huskyroboticsteam/Chassis-Power-Distro-PCB-A-2019-2020/Rev 1.1/PowerDistro BOM_2019-2020.xlsx

Item # | Description | Quantity | Value | Part Number | Link to Part | Manufacturer Part # | PackageReference | Price per Unit | Total Price
1 | CAPACITORS:
2 | CAP CER 3.3UF 35V X7R 0805 | 1 | 3.3u | 445-7553-1-ND | https://www.digikey.com/product-detail/en/tdk-corporation/C2012X7R1V335K125AC/445-7553-1-ND/2733625 | C2012X7R1V335K125AC | 0805 | $0.59 | $0.59
3 | CAP CER 0.47UF 50V X7R 0805 | 3 | 470n | 399-8100-1-ND | https://www.digikey.com/product-detail/en/kemet/C0805C474K5RACTU/399-8100-1-ND/3471823 | C0805C474K5RACTU | 0805 | $0.35 | $1.05 | ???
4 | CAP CER 0.1UF 50V X7R 0805 | 8 | 0.1u | 399-1169-1-ND | https://www.digikey.com/product-detail/en/kemet/C0805C104M5RACTU/399-1169-1-ND/411444 | C0805C104M5RACTU | 0805 | $0.10 | $0.80
5 | CAP CER 2.2UF 50V X7R 0805 | 21 | 2.2u | 445-174216-1-ND | https://www.digikey.com/product-detail/en/tdk-corporation/CGA4J3X7R1H225K125AB/445-174216-1-ND/5823086 | CGA4J3X7R1H225K125AB | 0805 | $0.49 | $10.29
6 | CAP ALUM 680UF 20% 35V RADIAL | 3 | 680u | P12417-ND | https://www.digikey.com/product-detail/en/panasonic-electronic-components/EEU-FM1V681/P12417-ND/613778 | EEU-FM1V681 | Radial | $0.85 | $2.55
7 | CAP ALUM 330UF 20% 35V RADIAL | 3 | 330u | P10299-ND | https://www.digikey.com/product-detail/en/panasonic-electronic-components/EEU-FC1V331/P10299-ND/266308 | EEU-FC1V331 | Radial | $0.63 | $1.89
8 | CAP CER 820PF 50V X7R 0805 | 4 | 820p | 399-1145-1-ND | https://www.digikey.com/product-detail/en/kemet/C0805C821K5RACTU/399-1145-1-ND/411420 | C0805C821K5RACTU | 0805 | $0.32 | $1.28
9 | CAP CER 22UF 35V JB 0805 | 7 | 22u | 445-11527-1-ND | https://www.digikey.com/product-detail/en/tdk-corporation/C2012JB1V226M125AC/445-11527-1-ND/3953193 | C2012JB1V226M125AC | 0805 | $1.14 | $7.98
10 | CAP CER 0.015UF 25V X7R 0805 | 3 | 15n | 732-8056-1-ND | https://www.digikey.com/product-detail/en/w-rth-elektronik/885012207067/732-8056-1-ND/5454683 | 885012207067 | 0805 | $0.10 | $0.30
11 | CAP CER 0.47UF 50V X7R 0805 | 3 | 0.47u | 399-8100-1-ND | https://www.digikey.com/product-detail/en/kemet/C0805C474K5RACTU/399-8100-1-ND/3471823 | C0805C474K5RACTU | 0805 | $0.35 | $1.05
12 | CAP CER 1000PF 50V X7R 0805 | 3 | 1000p | 399-1149-1-ND | https://www.digikey.com/product-detail/en/kemet/C0805C102J5RACTU/399-1149-1-ND/411424 | C0805C102J5RACTU | 0805 | $0.15 | $0.45
13 | CAP CER 82PF 50V C0G/NP0 0805 | 2 | 82p | 399-1120-1-ND | https://www.digikey.com/product-detail/en/kemet/C0805C820J5GACTU/399-1120-2-ND/411119 | C0805C820J5GACTU | 0805 | $0.17 | $0.34
14 | CAP CER 9100PF 50V C0G/NP0 0805 | 1 | 9n | 399-15072-1-ND | https://www.digikey.com/product-detail/en/kemet/C0805C912J5GAC7800/399-15072-1-ND/7382621 | C0805C912J5GAC7800 | 0805 | $0.87 | $0.87
15 | CAP CER 3900PF 50V X7R 0805 | 1 | 4n | 399-1154-1-ND | https://www.digikey.com/product-detail/en/kemet/C0805C392K5RACTU/399-1154-1-ND/411429 | C0805C392K5RACTU | 0805 | $0.11 | $0.11
16 | CAP CER 12PF 25V C0G/NP0 0805 | 1 | 12p | 399-17427-1-ND | https://www.digikey.com/product-detail/en/kemet/C0805C120J3GAC7800/399-17427-1-ND/8570394 | C0805C120J3GAC7800 | 0805 | $0.25 | $0.25
17
18 | RESISTORS:
19
20 | RES SMD 4.32K OHM 0.5% 1/4W 0805 | 3 | 4.32k | P21091CT-ND | https://www.digikey.com/product-detail/en/panasonic-electronic-components/ERJ-PB6D4321V/P21091CT-ND/6215346 | ERJ-PB6D4321V | 0805 | $0.25 | $0.75 |  | Missing: | 14k ohm | R29
21 | RES 10 OHM 1/4W 5% AXIAL | 12 | 10ohms | CF14JT10R0CT-ND | https://www.digikey.com/product-detail/en/stackpole-electronics-inc/CF14JT10R0/CF14JT10R0CT-ND/1830306 | CF14JT10R0 | Axial | $0.10 | $1.20 |  |  | 60.8k ohm | R34
22 | RES SMD 45.3K OHM 0.5% 1/4W 0805 | 1 | 45.3k | P21207CT-ND | https://www.digikey.com/product-detail/en/panasonic-electronic-components/ERJ-PB6D4532V/P21207CT-ND/6215462 | ERJ-PB6D4532V | 0805 | $0.25 | $0.25
23 | RES 2K OHM 1% 1/4W 0805 | 1 | 2k | RNCP0805FTD2K00CT-ND | https://www.digikey.com/product-detail/en/stackpole-electronics-inc/RNCP0805FTD2K00/RNCP0805FTD2K00CT-ND/2240576 | RNCP0805FTD2K00 | 0805 | $0.10 | $0.10
24 | RES SMD 316 OHM 0.1% 1/4W 0805 | 1 | 316ohms | P20535CT-ND | https://www.digikey.com/product-detail/en/panasonic-electronic-components/ERJ-PB6B3160V/P20535CT-ND/6214790 | ERJ-PB6B3160V | 0805 | $0.36 | $0.36
25 | RES SMD 340 OHM 0.1% 1/4W 0805 | 1 | 340ohms | A110498CT-ND | https://www.digikey.com/product-detail/en/te-connectivity-passive-product/7-2176091-3/A110498CT-ND/4034853 | 7-2176091-3 | 0805 | $0.66 | $0.66
26 | RES SMD 5.1K OHM 0.5% 1/4W 0805 | 3 | 5.1k | P21099CT-ND | https://www.digikey.com/product-detail/en/panasonic-electronic-components/ERJ-PB6D5101V/P21099CT-ND/6215354 | ERJ-PB6D5101V | 0805 | $0.25 | $0.75
27 | RES SMD 12.1K OHM 0.5% 1/4W 0805 | 3 | 12.1k | P21142CT-ND | https://www.digikey.com/product-detail/en/panasonic-electronic-components/ERJ-PB6D1212V/P21142CT-ND/6215397 | ERJ-PB6D1212V | 0805 | $0.25 | $0.75
28 | RES 0.012 OHM 1% 1W 2512 | 3 | 12m | P12MCT-ND | https://www.digikey.com/product-detail/en/panasonic-electronic-components/ERJ-M1WSF12MU/P12MCT-ND/300474 | ERJ-M1WSF12MU | 2412 | $0.70 | $2.10
29 | RES 8.76K OHM 0.1% 1/5W 0805 | 1 | 8.76k | 541-4579-1-ND | https://www.digikey.com/product-detail/en/vishay-dale/TNPW08058K76BEEA/541-4579-1-ND/9448583 | TNPW08058K76BEEA | 0805 | $0.60 | $0.60
30 | RES SMD 88.7 OHM 0.1% 1/4W 0805 | 1 | 86.7ohms | A110442CT-ND | https://www.digikey.com/product-detail/en/te-connectivity-passive-product/1-2176091-9/A110442CT-ND/4034797 | 1-2176091-9 | 0805 | $0.66 | $0.66
31 | RES SMD 68.1K OHM 0.1% 1/4W 0805 | 1 | 68.1k | A110719CT-ND | https://www.digikey.com/product-detail/en/te-connectivity-passive-product/7-2176093-9/A110719CT-ND/4035074 | 7-2176093-9 | 0805 | $0.66 | $0.66
32 | RES SMD 6.04K OHM 0.1% 1/4W 0805 | 1 | 6.04k | P20683CT-ND | https://www.digikey.com/product-detail/en/panasonic-electronic-components/ERJ-PB6B6041V/P20683CT-ND/6214938 | ERJ-PB6B6041V | 0805 | $0.36 | $0.36 | ???
33 | RES SMD 1.15K OHM 0.1% 1/4W 0805 | 1 | 1.15k | P20600CT-ND | https://www.digikey.com/product-detail/en/panasonic-electronic-components/ERJ-PB6B1151V/P20600CT-ND/6214855 | ERJ-PB6B1151V | 0805 | $0.36 | $0.36 | ???
34 | RES SMD 44.2K OHM 0.1% 1/4W 0805 | 1 | 44.2k | P20781CT-ND | https://www.digikey.com/product-detail/en/panasonic-electronic-components/ERJ-PB6B4422V/P20781CT-ND/6215036 | ERJ-PB6B4422V | 0805 | $0.36 | $0.36
35 | RES SMD 154K OHM 0.1% 1/4W 0805 | 1 | 154k | P20841CT-ND | https://www.digikey.com/product-detail/en/panasonic-electronic-components/ERJ-PB6B1543V/P20841CT-ND/6215096 | ERJ-PB6B1543V | 0805 | $0.36 | $0.36
36 | RES SMD 60.4K OHM 0.1% 1/4W 0805 | 1 | 60.8k | P20797CT-ND | https://www.digikey.com/product-detail/en/panasonic-electronic-components/ERJ-PB6B6042V/P20797CT-ND/6215052 | ERJ-PB6B6042V | 0805 | $0.36 | $0.36
37 | RES SMD 665 OHM 0.1% 1/4W 0805 | 1 | 667ohms | P20574CT-ND | https://www.digikey.com/product-detail/en/panasonic-electronic-components/ERJ-PB6B6650V/P20574CT-ND/6214829 | ERJ-PB6B6650V | 0805 | $0.36 | $0.36
38 | RES SMD 1.47K OHM 0.1% 1/4W 0805 | 2 | 1.47k | P20611CT-ND | https://www.digikey.com/product-detail/en/panasonic-electronic-components/ERJ-PB6B1471V/P20611CT-ND/6214866 | ERJ-PB6B1471V | 0805 | $0.36 | $0.72
39 | RES SMD 0 OHM JUMPER 1/2W 0805 | 3 | 0 | 541-0.0TBCT-ND | https://www.digikey.com/product-detail/en/vishay-dale/CRCW08050000Z0EAHP/541-0.0TBCT-ND/2222831 | CRCW08050000Z0EAHP | 0805 | $0.23 | $0.69
40
41 | ICs/Other:
42 | FUSE BOARD MOUNT 2A 32VDC 0805 | 1 |  | 749-1743-1-ND | https://www.digikey.com/product-detail/en/vishay-beyschlag/MFU0805FF02000P500/749-1743-1-ND/7348051 | MFU0805FF02000P500 |  | $0.48 | $0.48
43 | CONN HDR 2POS 7.50MM PCB SLDR | 3 |  | WM16294-ND | https://www.digikey.com/products/en?keywords=1720420202 | 1720420202 |  | $1.84 | $5.52
44 | Fixed Inductors 15uH 20% 13.8A 18.6mOhms AEC-Q200 | 1 |  | 994-XAL1010-153MEB | https://www.mouser.com/ProductDetail/Coilcraft/XAL1010-153MEB | XAL1010-153MEB |  | $5.25 | $5.25
45 | Fixed Inductors 6.8uH 20% 18.5A 8.9mOhms AEC-Q200 | 2 |  | 994-XAL1010-682MEB | https://www.mouser.com/ProductDetail/Coilcraft/XAL1010-682MEB | XAL1010-682MEB |  | $5.25 | $10.50
46 | MOSFET N-CH 60V 115MA SOT-23 | 3 |  | 2N7002NCT-ND | https://www.digikey.com/product-detail/en/on-semiconductor/2N7002/2N7002NCT-ND/244664 | 2N7002 |  | $0.33 | $0.99
47 | SWITCH TACTILE SPST-NO 0.05A 24V | 1 |  | 450-1804-ND | https://www.digikey.com/product-detail/en/te-connectivity-alcoswitch-switches/1825910-7/450-1804-ND/1731414 | 1825910-7 |  | $0.11 | $0.11
48 | IC REG LINEAR 5V 700MA TO220-5 | 1 |  | LT1129CT-5#PBF-ND | https://www.digikey.com/products/en?keywords=LT1129CT-5%23PBF | LT1129CT-5#PBF |  | $5.20 | $5.20
49 | DIODE SCHOTTKY 100V 150MA SOD123 | 3 |  | 641-1964-1-ND | https://www.digikey.com/product-detail/en/comchip-technology/CDBW46-G/641-1964-1-ND/9477893 | CDBW46-G |  | $0.29 | $0.87
50 | IC REG CTRLR BUCK 20TSSOP | 3 |  | 296-45007-5-ND | https://www.digikey.com/products/en?keywords=LM25117QPMH%2FNOPB | LM25117QPMH/NOPB |  | $5.76 | $17.28
51 | 40V N CH MOSFET | 6 |  | 296-47757-1-ND | https://www.digikey.com/product-detail/en/texas-instruments/CSD18514Q5A/296-47757-1-ND/8133106 | CSD18514Q5A |  | $0.92 | $5.52
52 | PC TEST POINT MINIATURE RED | 23 |  | 36-5000-ND | https://www.digikey.com/product-detail/en/keystone-electronics/5000/36-5000-ND/255326 | 5000 |  | $0.35 | $8.05
 |  |  |  |  |  |  | TOTAL: |  | $101.98
