huskyroboticsteam/Chassis-Power-Distro-PCB-A-2019-2020/ChassisPowerDistroA_1.0_GK.pdf

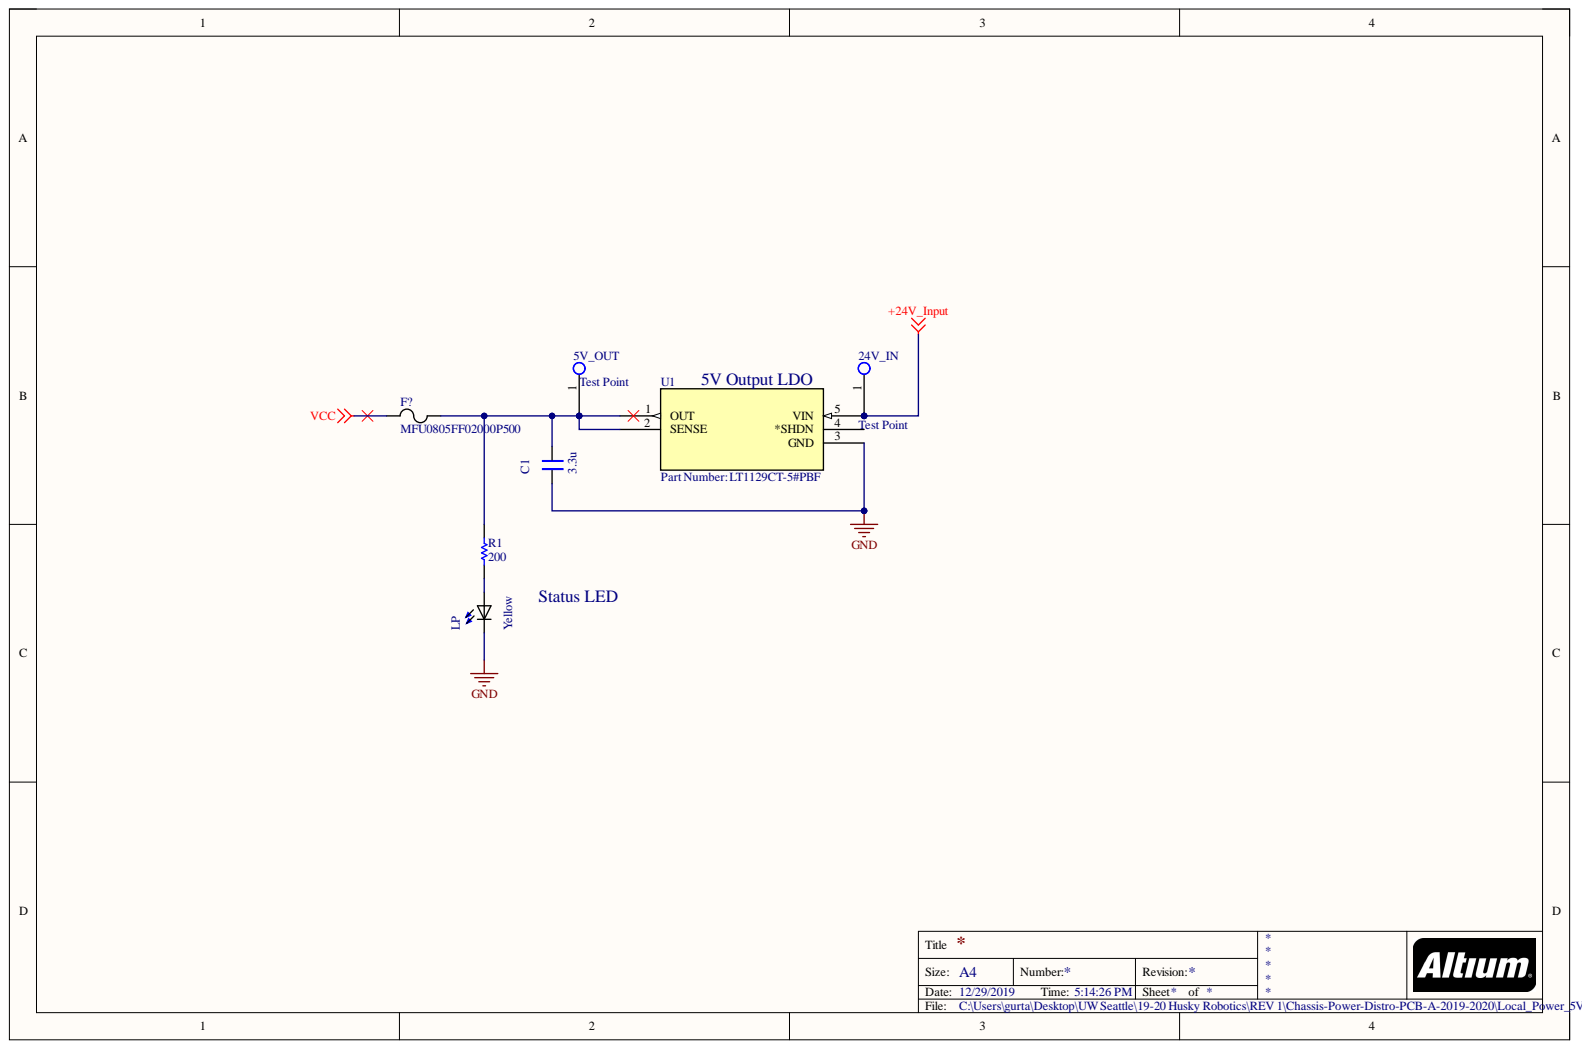
[picture p1: page 1]

Title * | * * * * *

Size: A4 | Number: * | Revision: *

Date: 12/29/2019 Time: 5:14:26 PM | | Sheet * of *

C:\Users\gurta\Desktop\UWSeattle\19-20 Husky Robotics\REV 1\Chassis-Power-Distro-PCB-A-2019-2020\Local_Power_5V.SchDoc

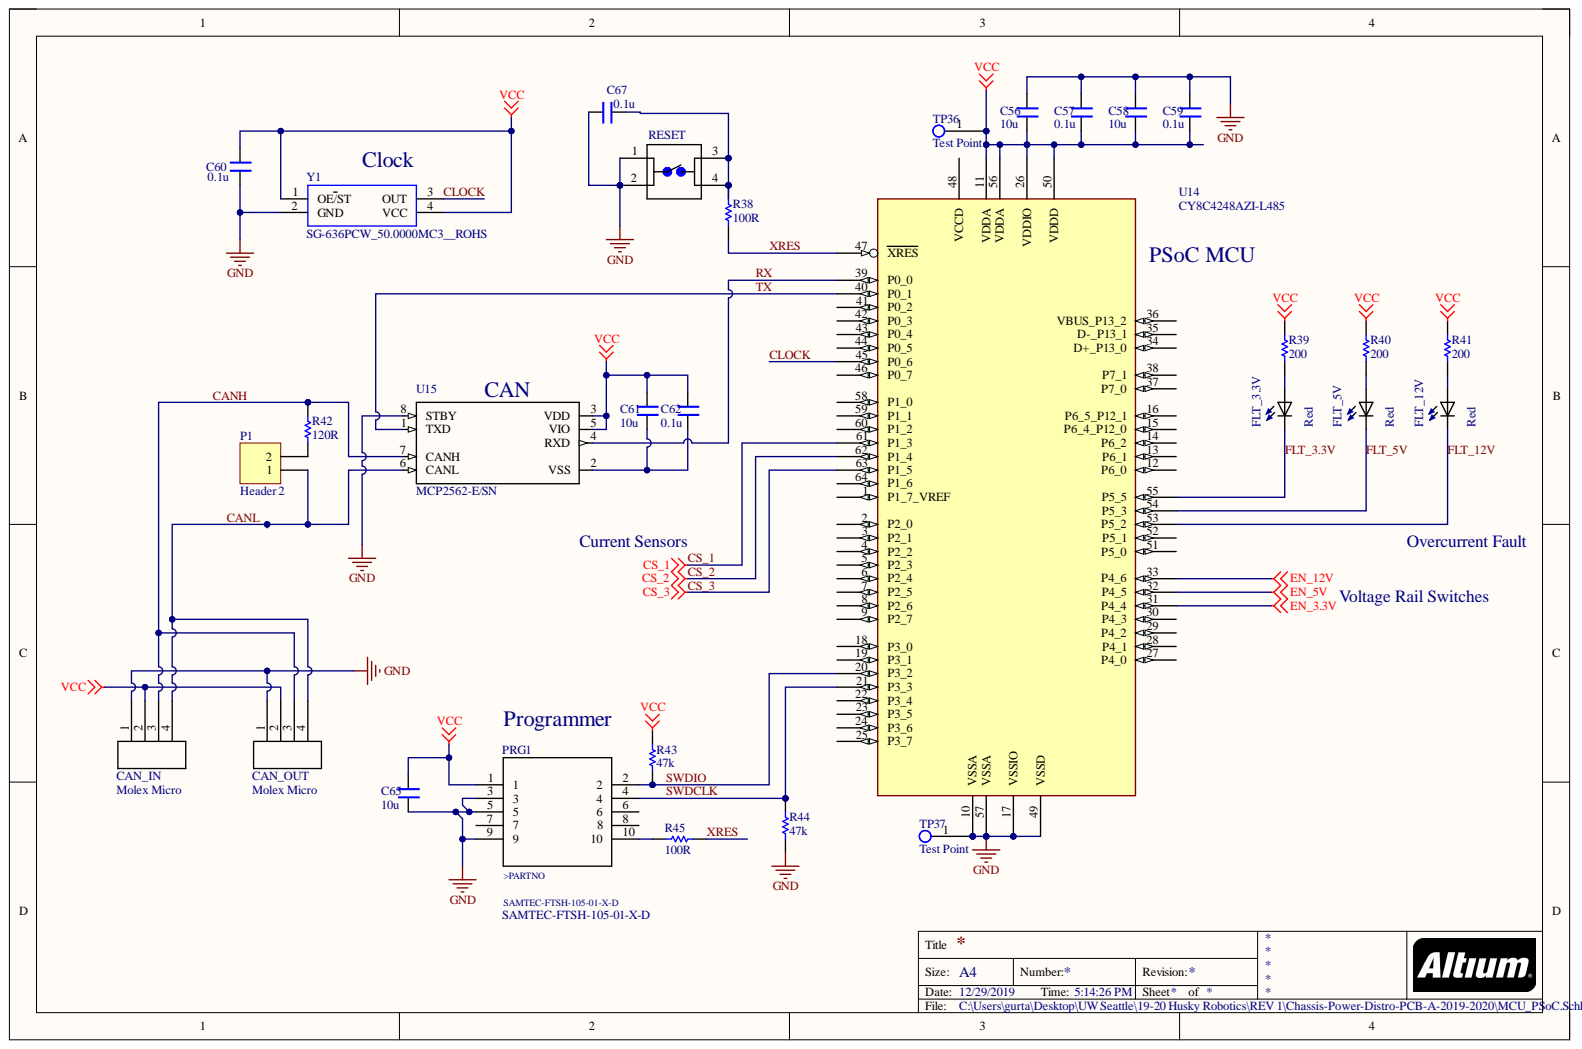
[picture p2: page 2]

VCC | CLOCK | P0_7 46 P0_6 45 P0_5 44 P0_4 43 P0_3 42 P0_2 41 P0_1 40 P0_0 39

CS_2 | P2_4 6
CS_3 | P2_5 7

Title * | * * * * *

Size: A4 | Number: * | Revision: *

Date: 12/29/2019 Time: 5:14:26 PM | | Sheet * of *

C:\Users\gurta\Desktop\UWSeattle\19-20 Husky Robotics\REV 1\Chassis-Power-Distro-PCB-A-2019-2020\MCU_PSoC.SchDoc

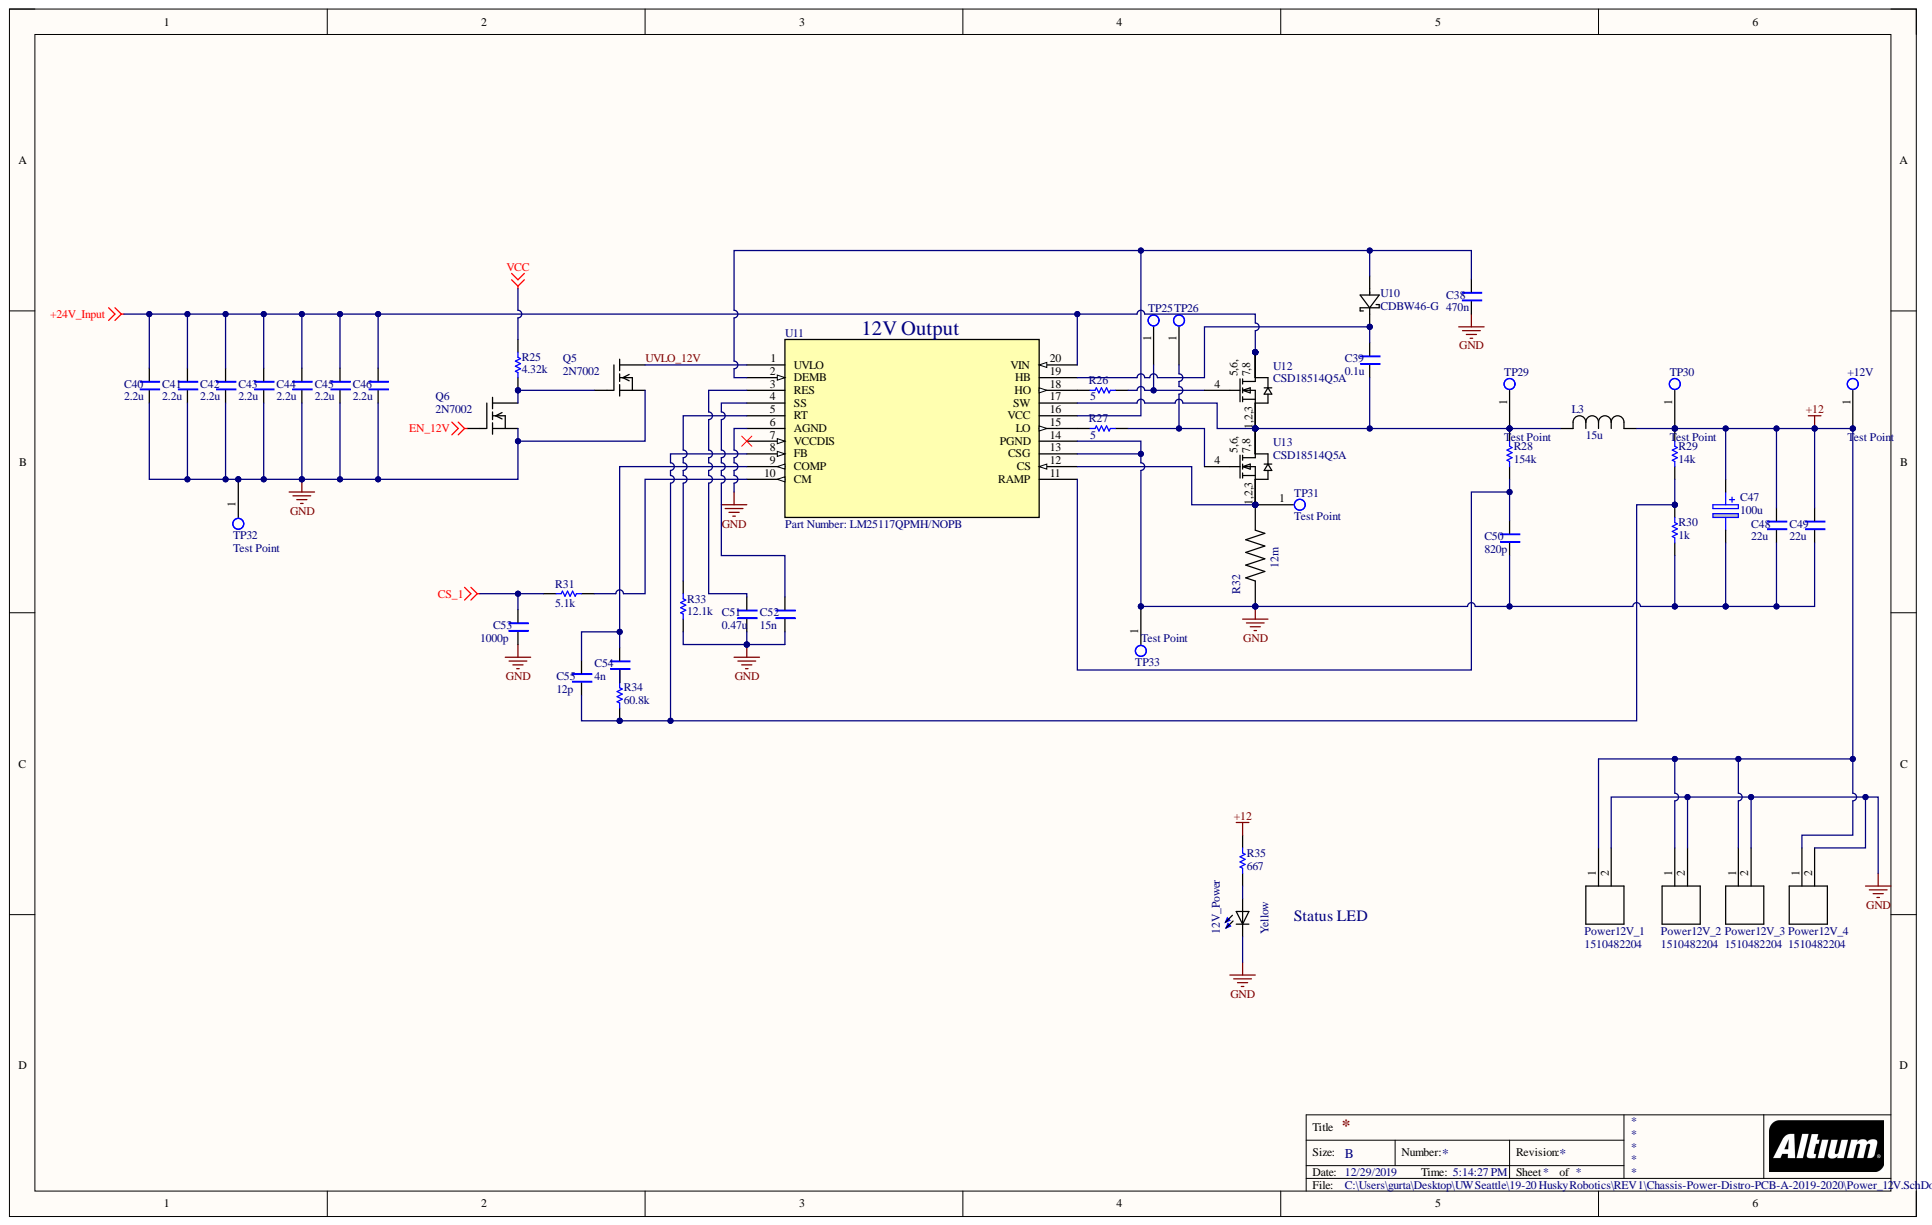
[picture p3: page 3]

RES 3 | R26 5
SS 4

AGND 6

Title * | * * * * *

Size: B | Number: * | Revision: *
Date: 12/29/2019 Time: 5:14:27 PM | | Sheet * of *

C:\Users\gurta\Desktop\UWSeattle\19-20 HuskyRobotics\REV1\Chassis-Power-Distro-PCB-A-2019-2020\Power_12V.SchDoc

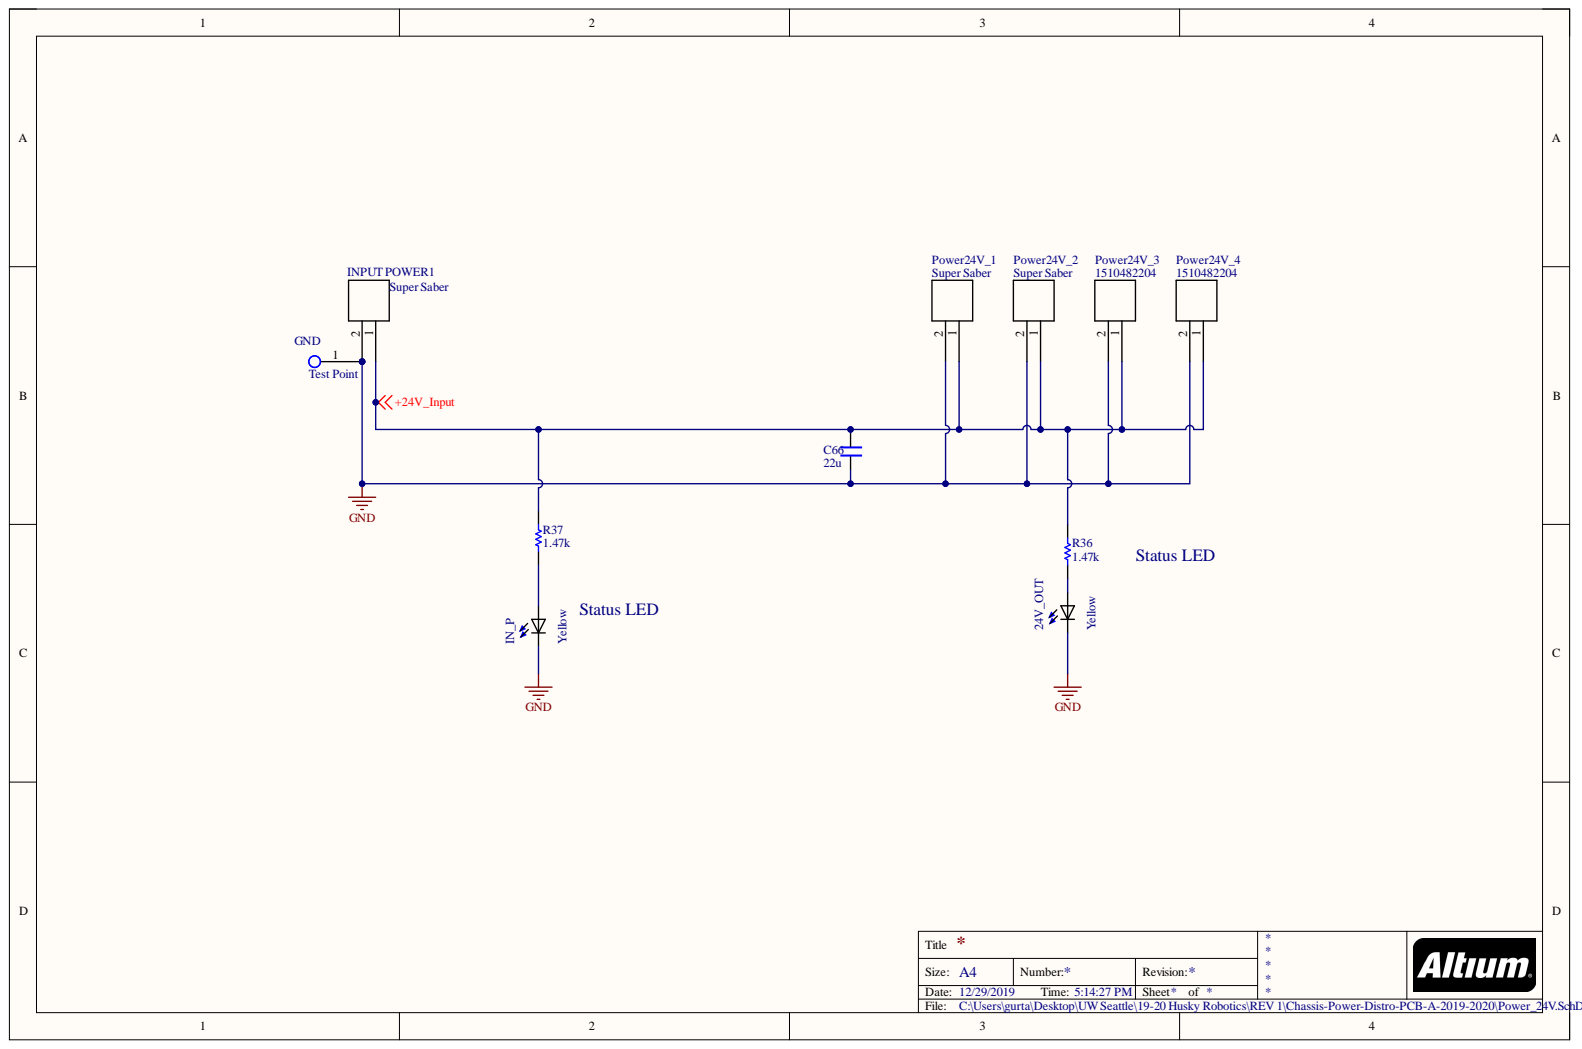
[picture p4: page 4]

Title * | * * * * *

Size: A4 | Number: * | Revision: *

Date: 12/29/2019 Time: 5:14:27 PM | | Sheet * of *

C:\Users\gurta\Desktop\UWSeattle\19-20 Husky Robotics\REV 1\Chassis-Power-Distro-PCB-A-2019-2020\Power_24V.SchDoc

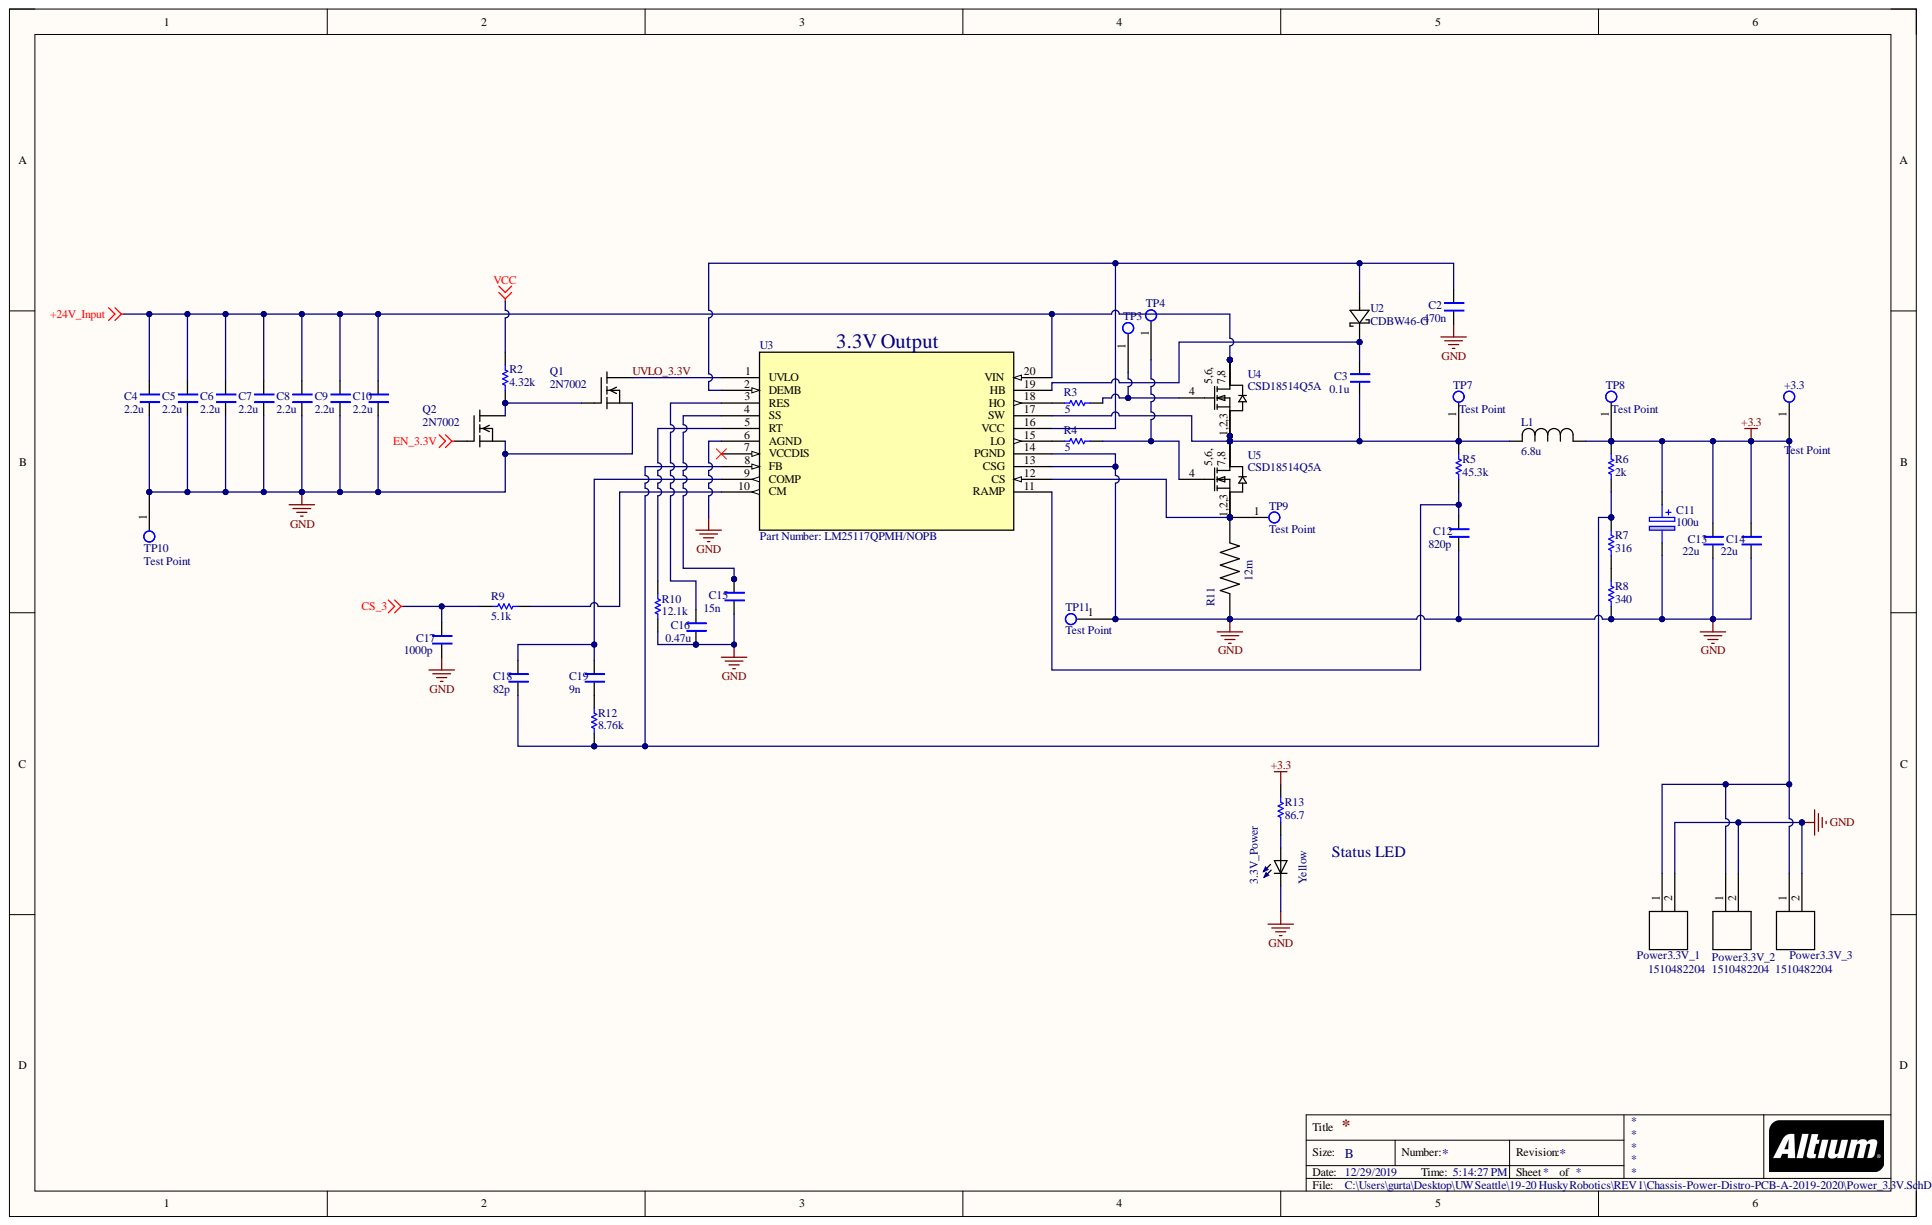
[picture p5: page 5]

RES 3 | R3 5
SS 4

AGND 6 | 5
VCCDIS 7

Title * | * * * * *

Size: B | Number: * | Revision: *
Date: 12/29/2019 Time: 5:14:27 PM | | Sheet * of *

C:\Users\gurta\Desktop\UWSeattle\19-20 HuskyRobotics\REV1\Chassis-Power-Distro-PCB-A-2019-2020\Power_3.3V.SchDoc

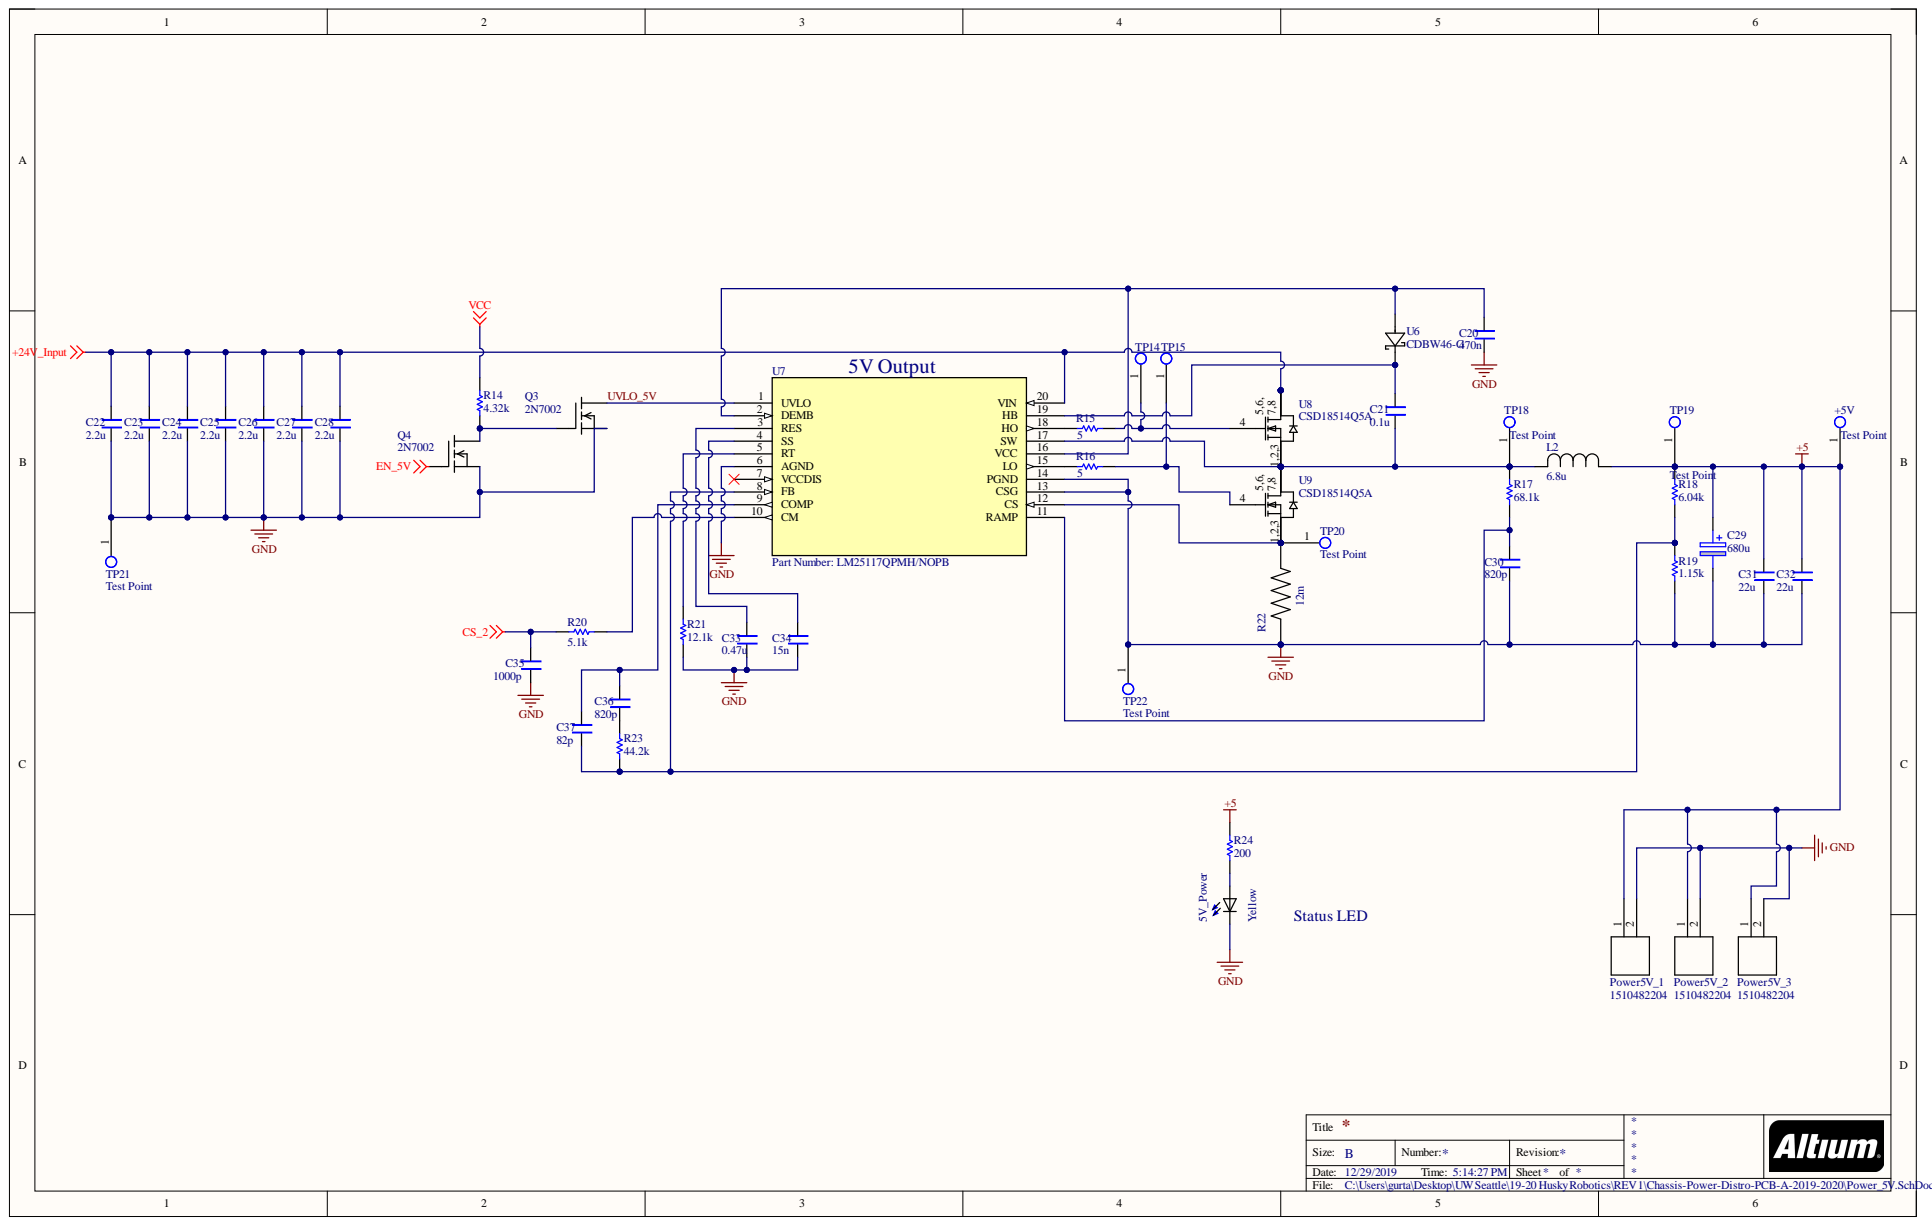
[picture p6: page 6]

RES 3 | R15 5
SS 4

Title * | * * * * *

Size: B | Number: * | Revision: *
Date: 12/29/2019 Time: 5:14:27 PM | | Sheet * of *

C:\Users\gurta\Desktop\UWSeattle\19-20 HuskyRobotics\REV1\Chassis-Power-Distro-PCB-A-2019-2020\Power_5V.SchDoc

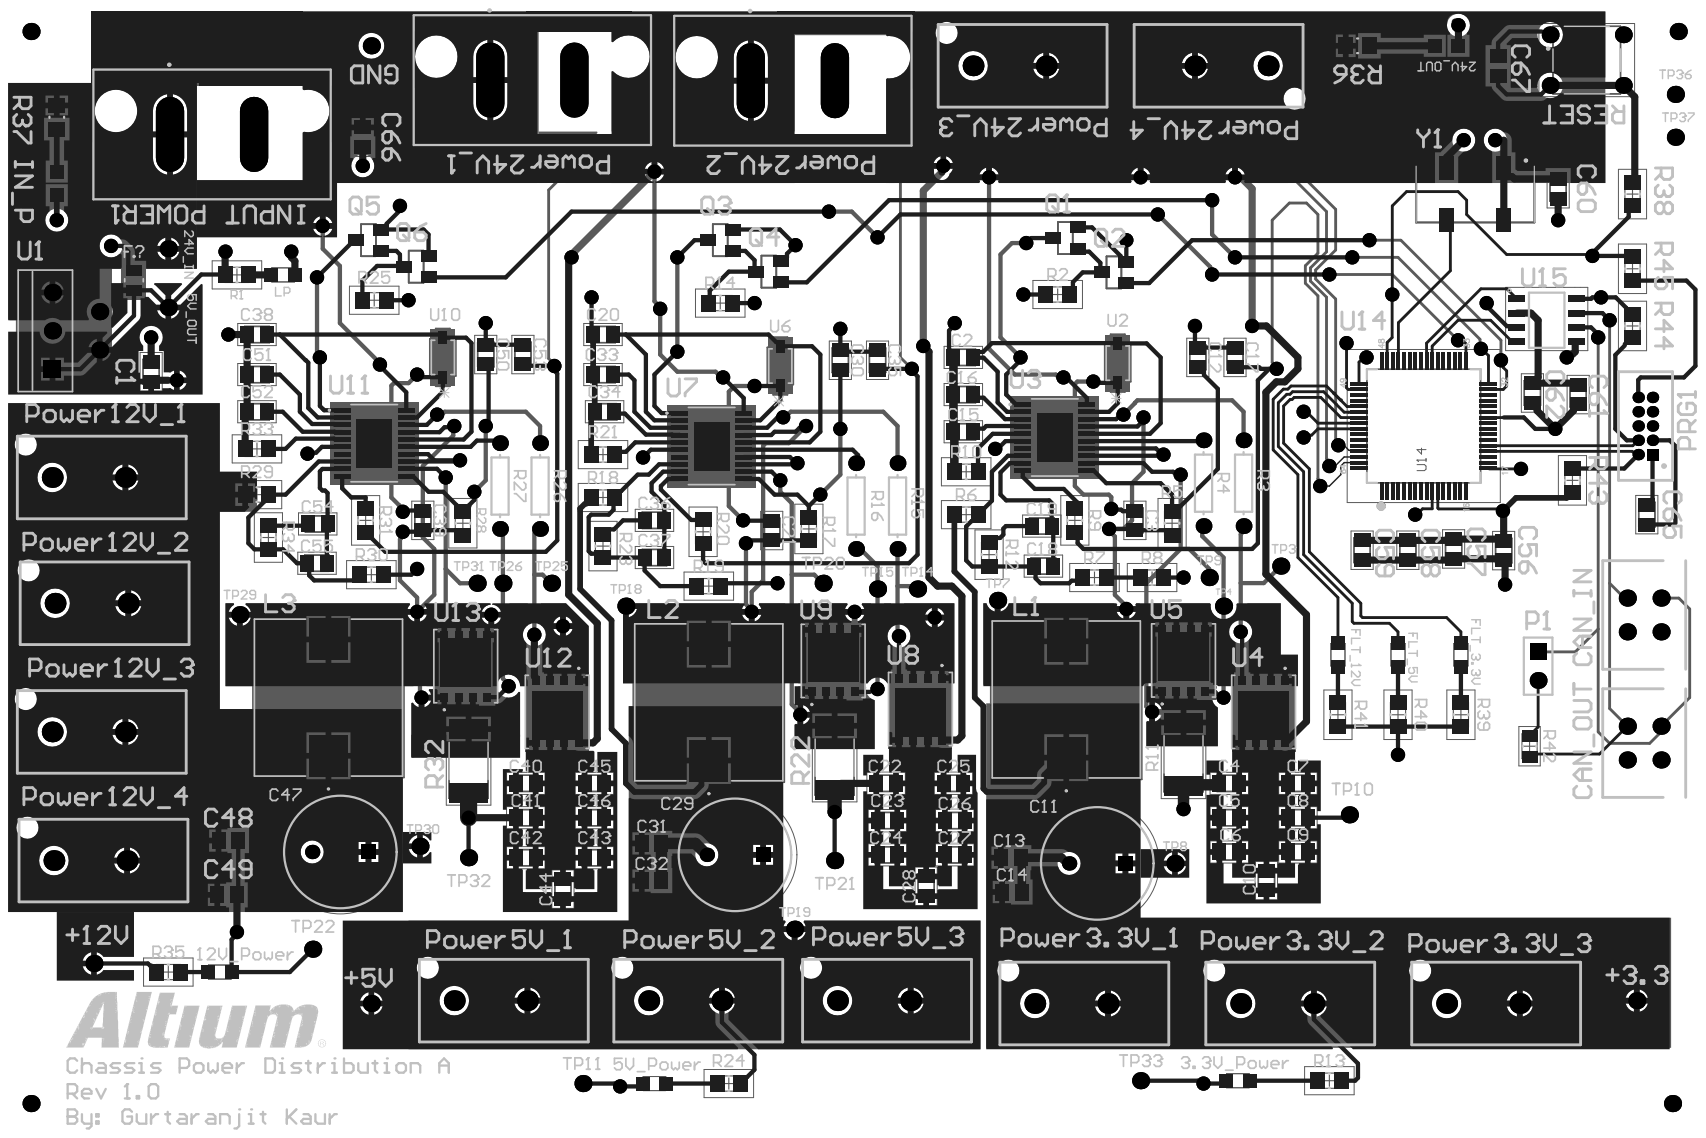
[picture p7: page 7]
