huskyroboticsteam/Chassis-Power-Distro-PCB-A-2019-2020/Rev 1.1/Design PDFs/ChassisPowerDistroA_1.1_GK.pdf

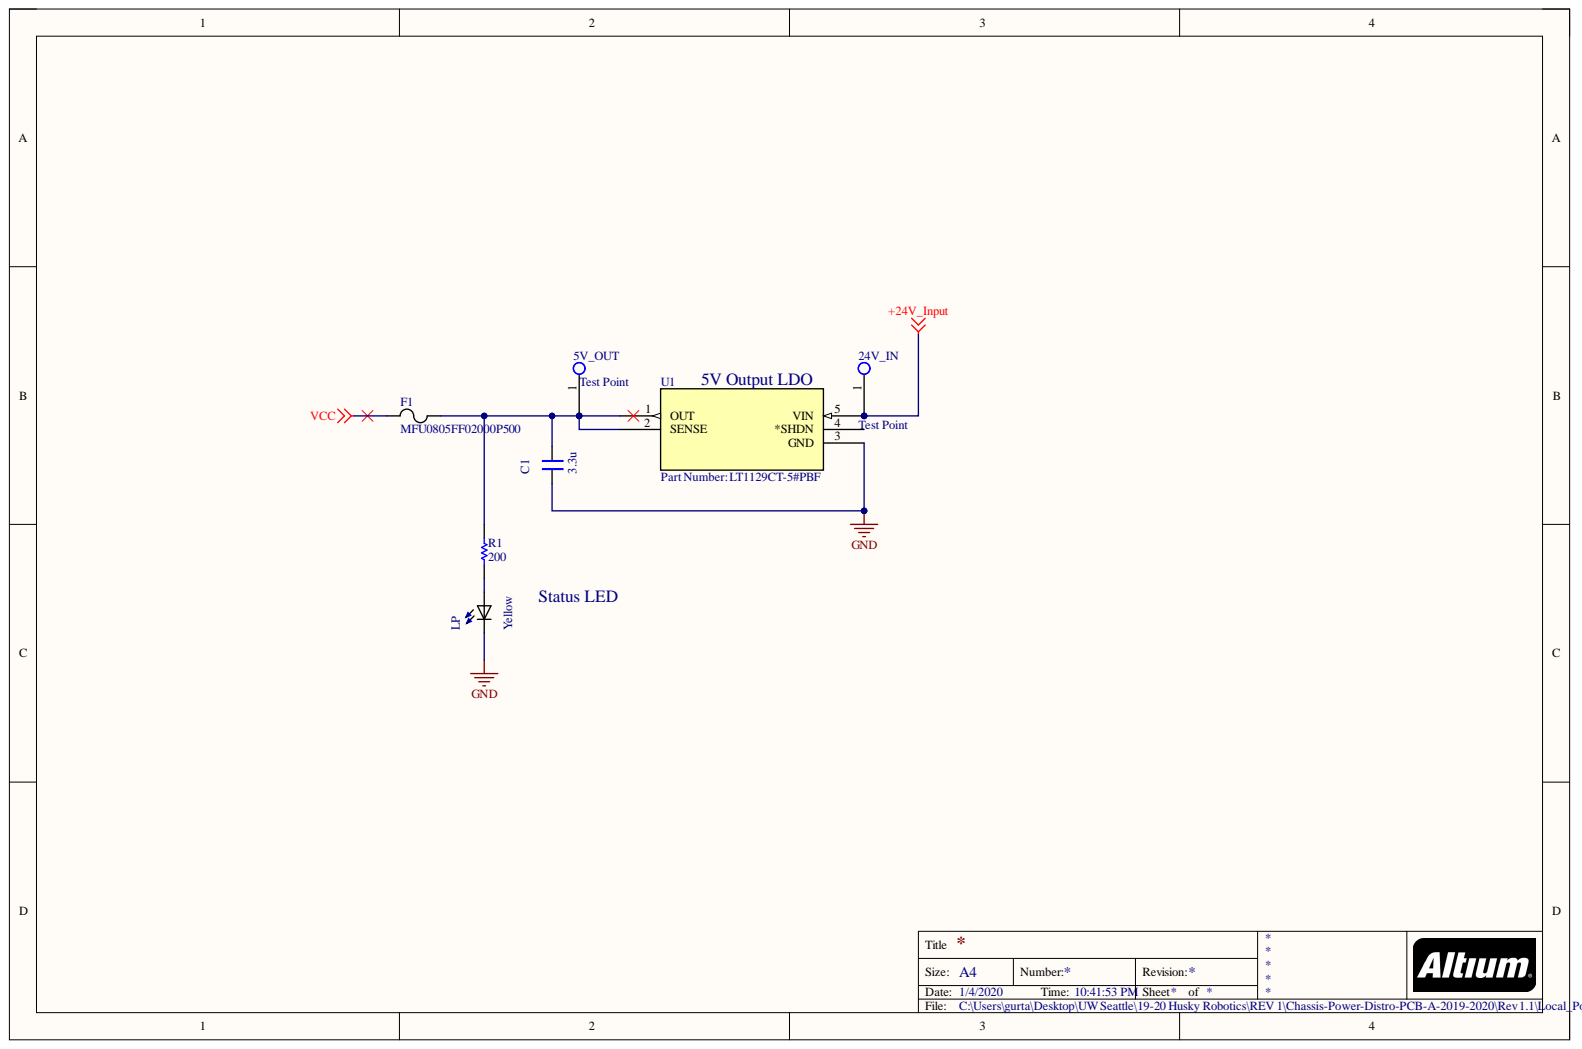
[picture p8: page 1]

Title * | * * * * *

Size: A4 | Number: * | Revision: *

Date: 1/4/2020 Time: 10:41:53 PM | | Sheet * of *

C:\Users\gurta\Desktop\UWSeattle\19-20 Husky Robotics\REV 1\Chassis-Power-Distro-PCB-A-2019-2020\Rev1.1\Local_Power_5V_Rev1.1.SchDoc

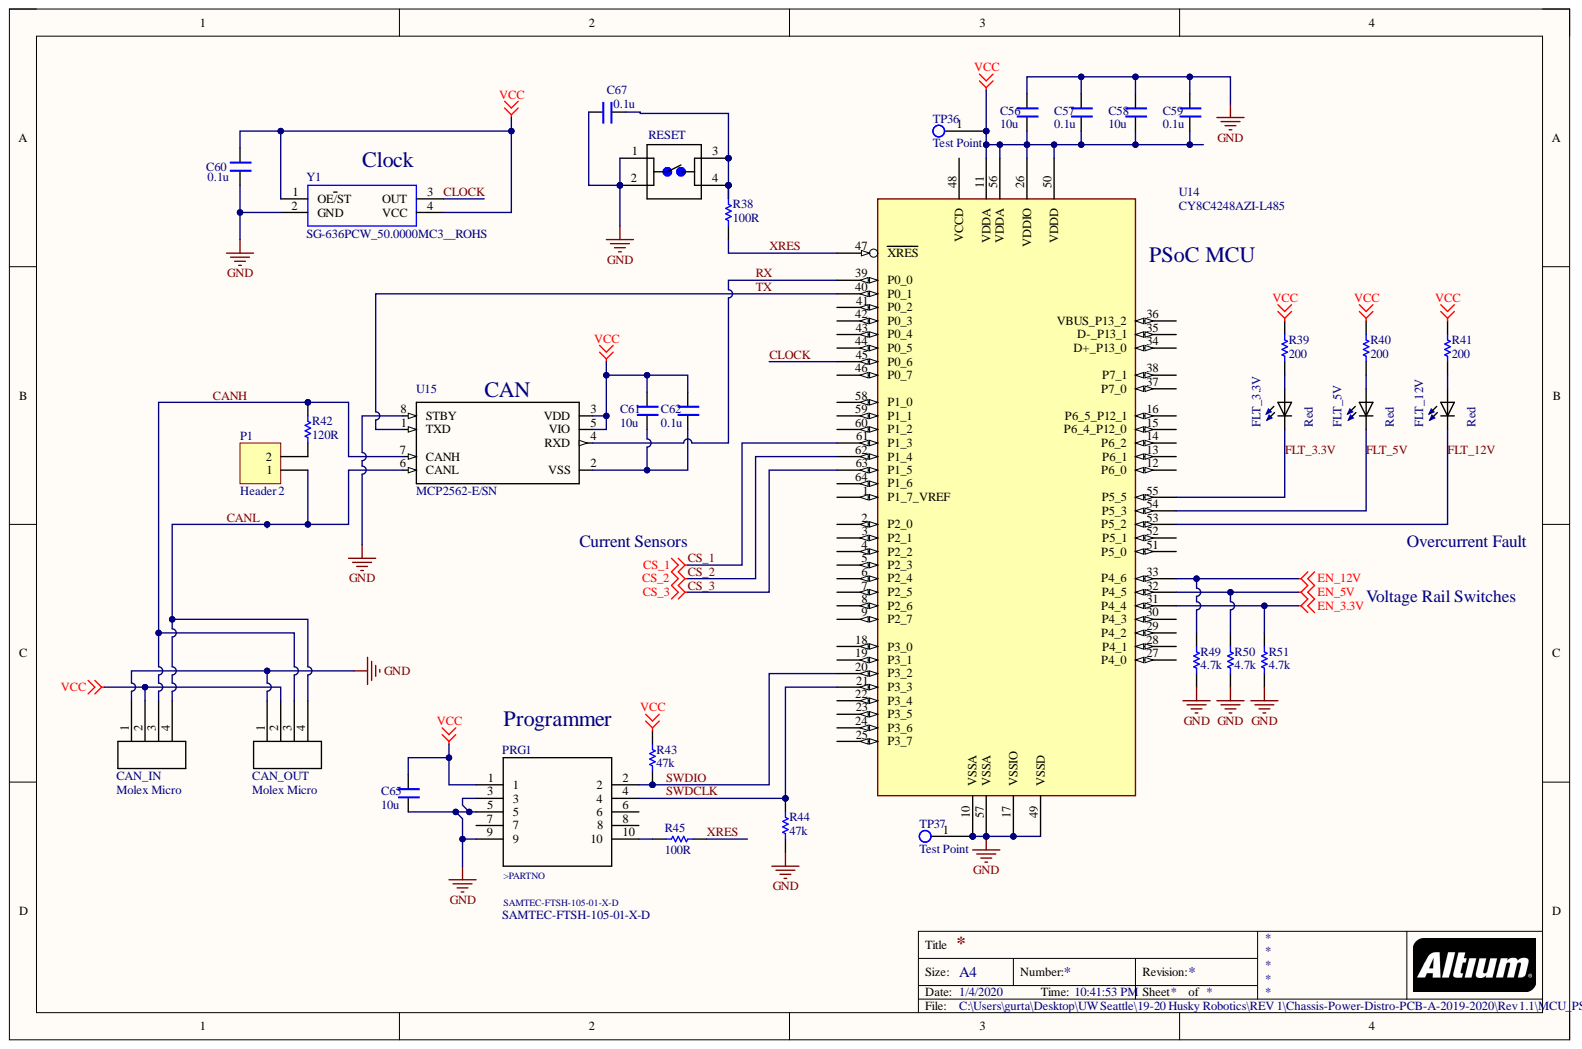
[picture p9: page 2]

VCC | CLOCK | P0_7 46 P0_6 45 P0_5 44 P0_4 43 P0_3 42 P0_2 41 P0_1 40 P0_0 39

CS_2 | P2_4 6
CS_3 | P2_5 7

Title * | * * * * *

Size: A4 | Number: * | Revision: *

Date: 1/4/2020 Time: 10:41:53 PM | | Sheet * of *

C:\Users\gurta\Desktop\UWSeattle\19-20 Husky Robotics\REV 1\Chassis-Power-Distro-PCB-A-2019-2020\Rev1.1\MCU_PSoC_Rev1.1.SchDoc

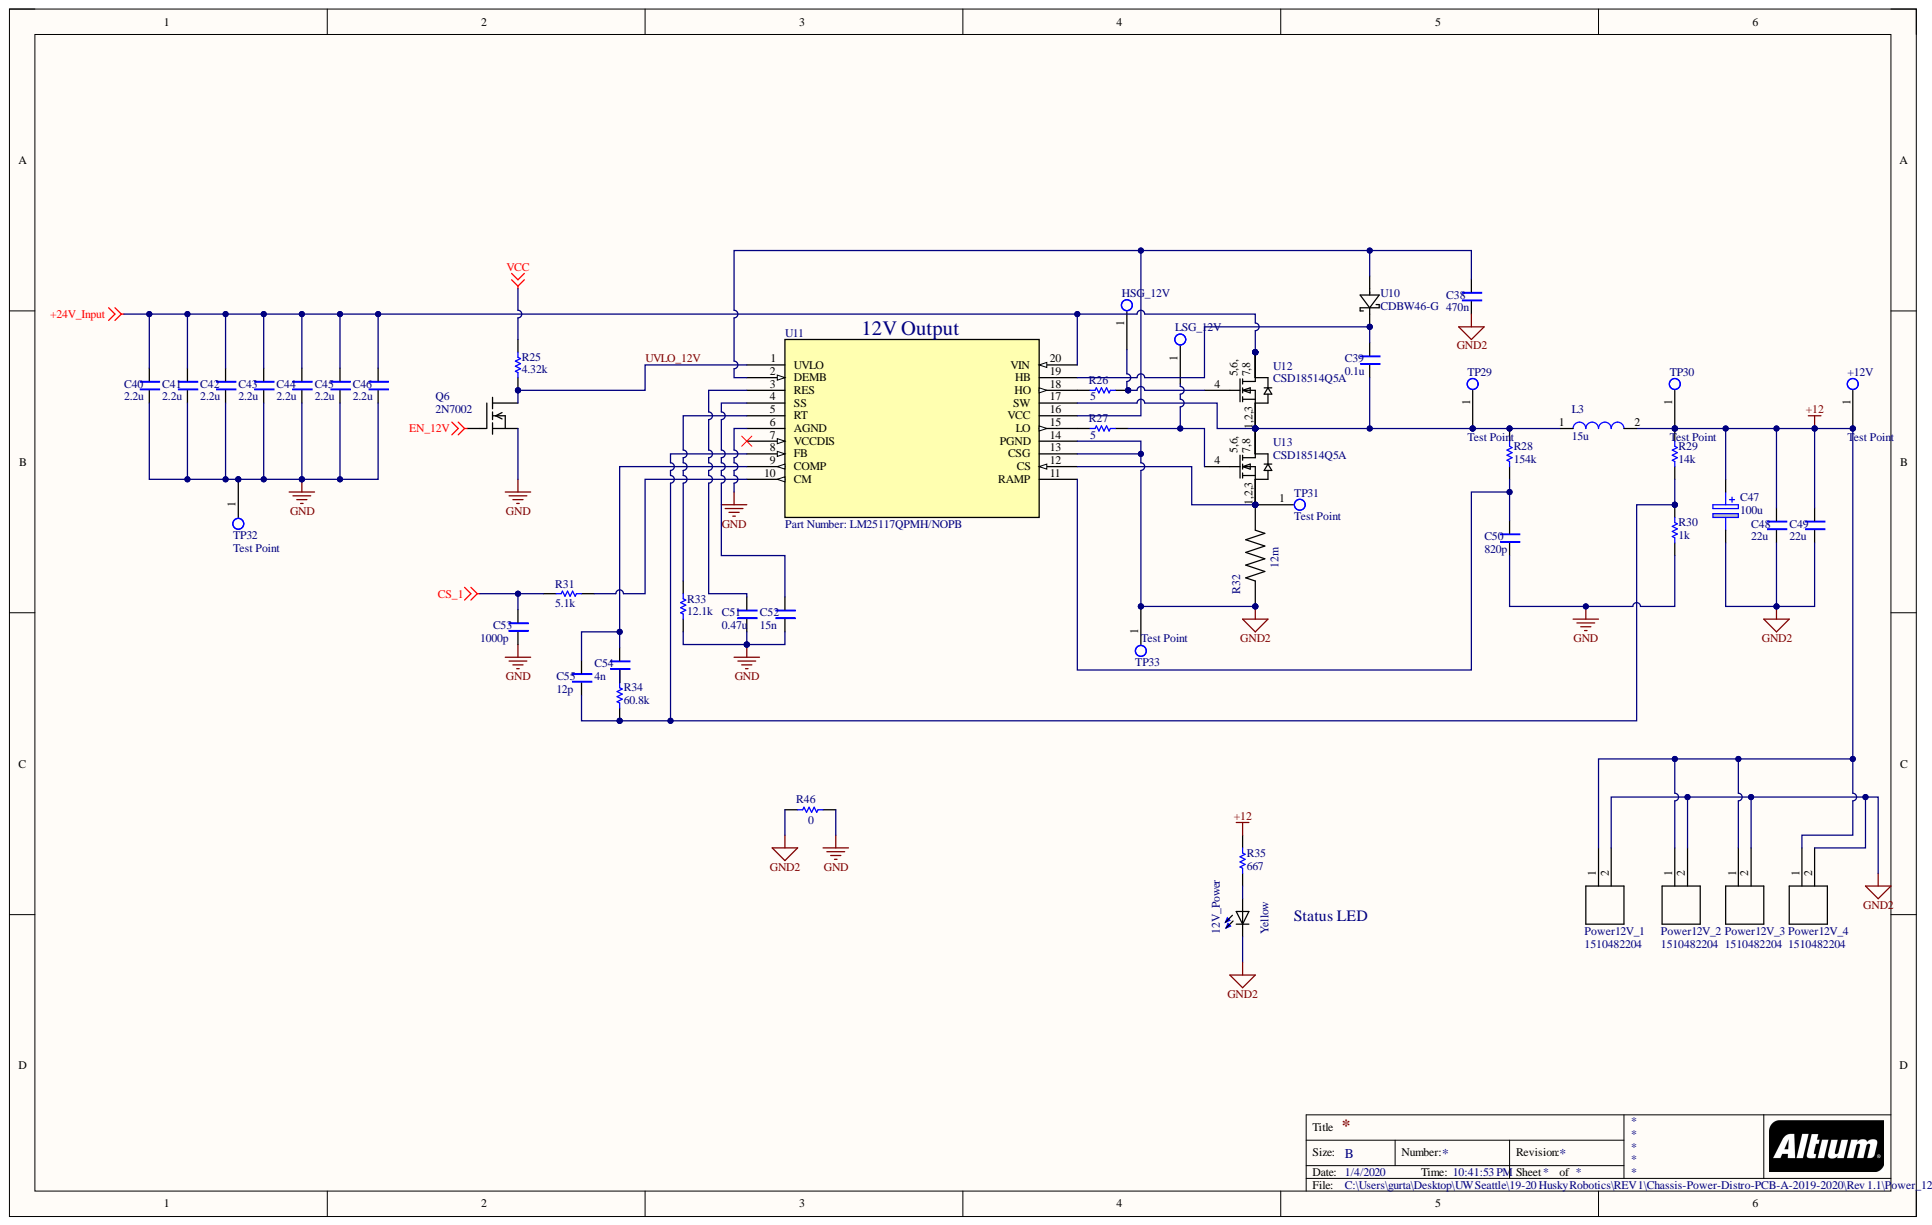
[picture p10: page 3]

4.32k | | DEMB 2

RES 3 | R26 5
SS 4

AGND 6

Title * | * * * * *

Size: B | Number: * | Revision: *
Date: 1/4/2020 Time: 10:41:53 PM | | Sheet * of *

C:\Users\gurta\Desktop\UWSeattle\19-20 HuskyRobotics\REV1\Chassis-Power-Distro-PCB-A-2019-2020\Rev 1.1\Power_12V_Rev1.1.SchDoc

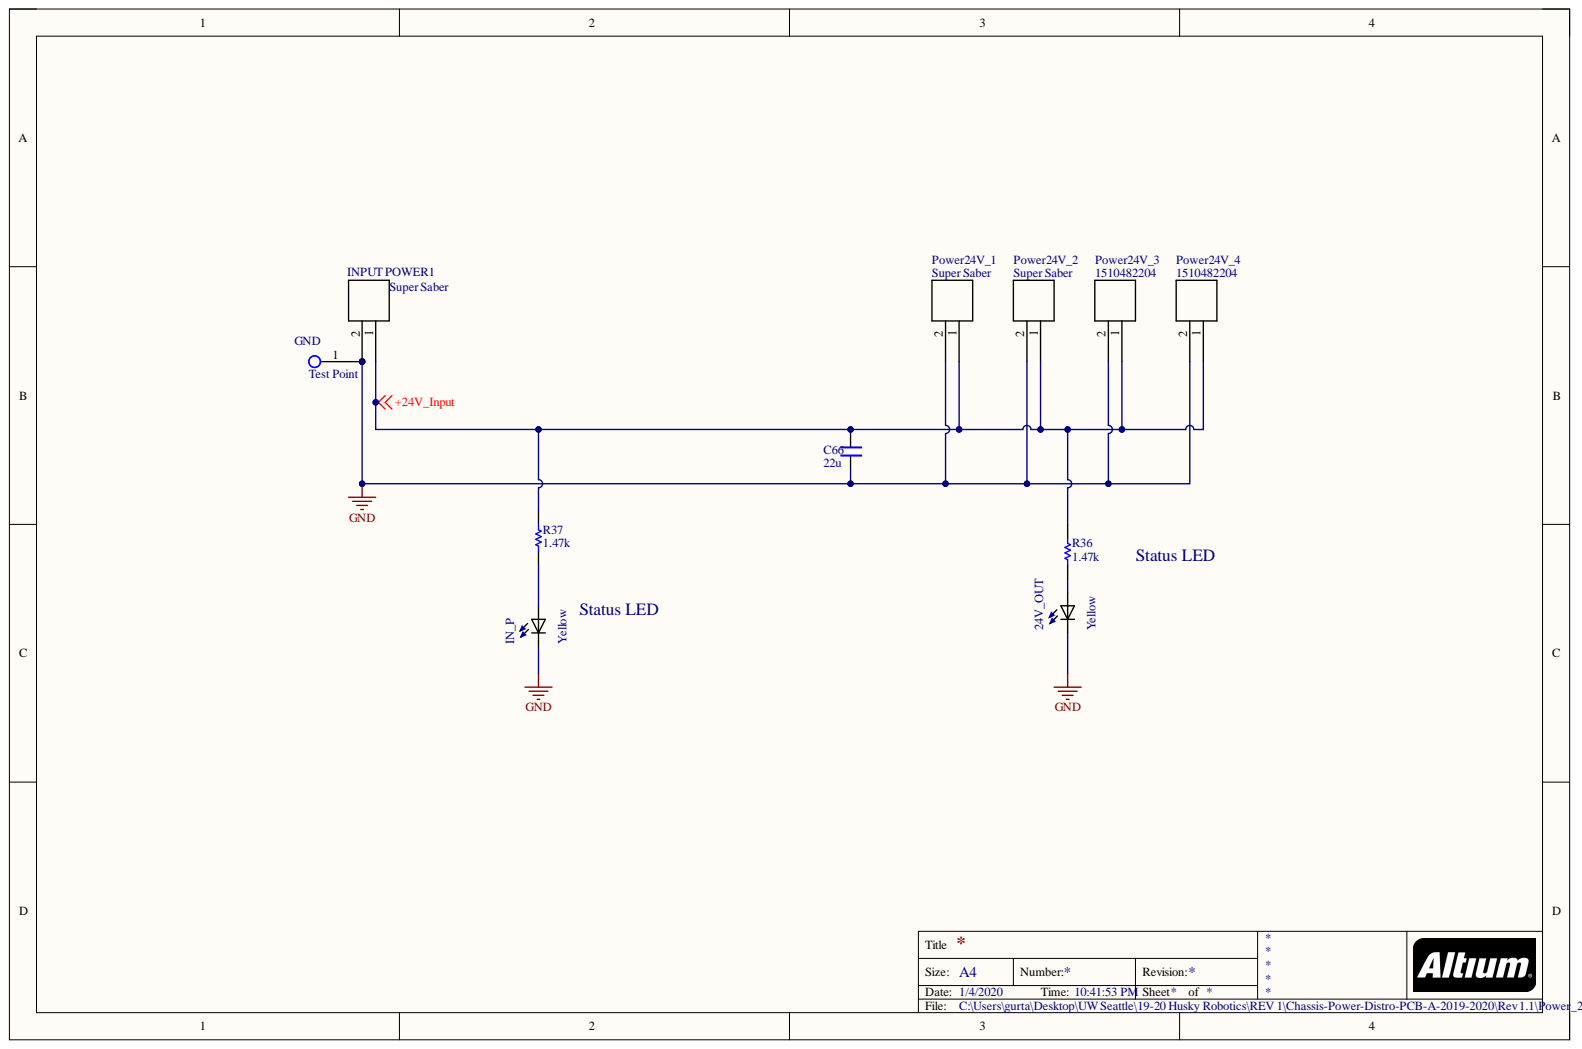
[picture p11: page 4]

Title * | * * * * *

Size: A4 | Number: * | Revision: *

Date: 1/4/2020 Time: 10:41:53 PM | | Sheet * of *

C:\Users\gurta\Desktop\UWSeattle\19-20 Husky Robotics\REV 1\Chassis-Power-Distro-PCB-A-2019-2020\Rev1.1\Power_24V_Rev1.1.SchDoc

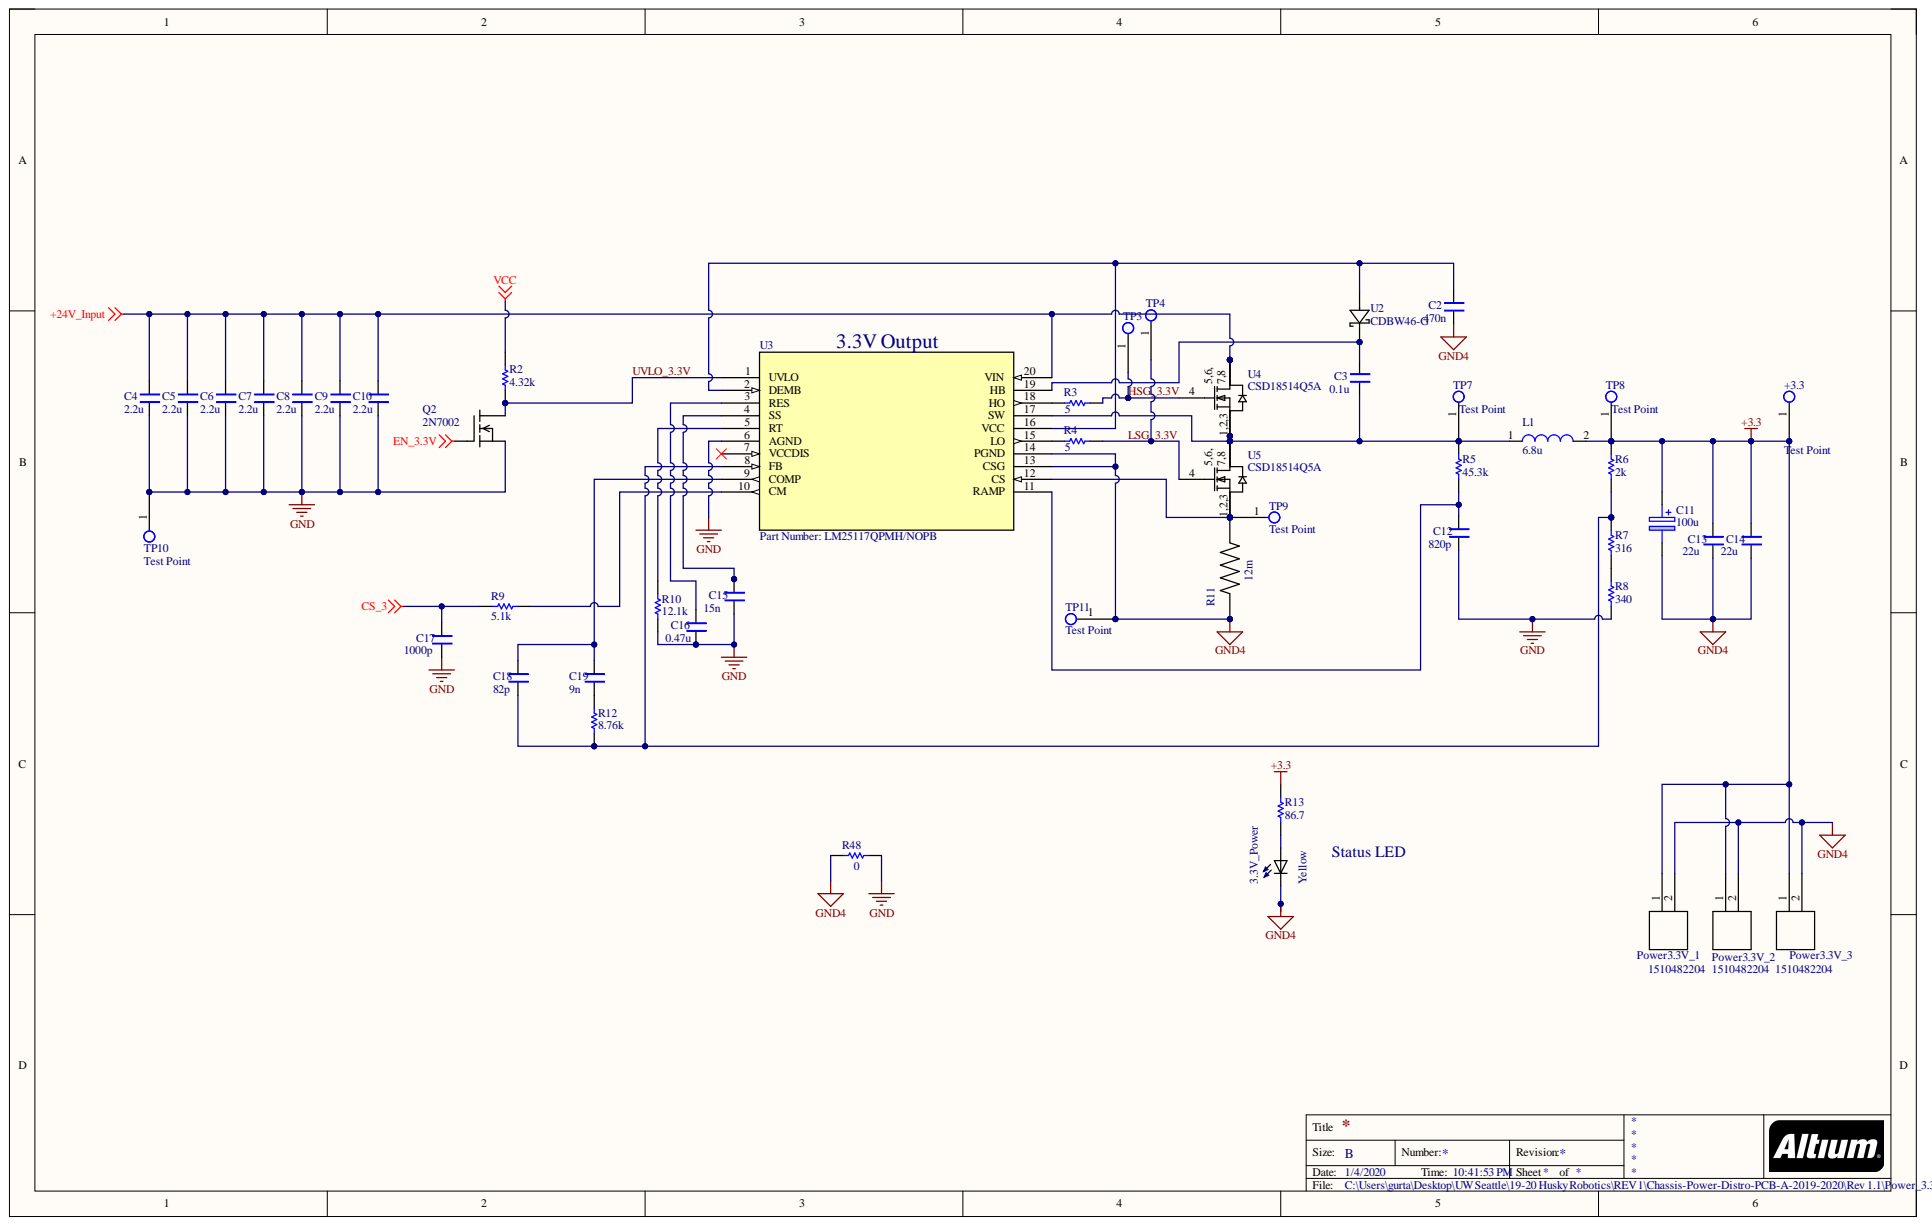
[picture p12: page 5]

4.32k | DEMB 2 | | HSG_3.3V

RES 3 | R3 5
SS 4
RT 5
AGND 6 | 5
VCCDIS 7

Title * | * * * * *

Size: B | Number: * | Revision: *
Date: 1/4/2020 Time: 10:41:53 PM | | Sheet * of *

C:\Users\gurta\Desktop\UWSeattle\19-20 HuskyRobotics\REV1\Chassis-Power-Distro-PCB-A-2019-2020\Rev 1.1\Power_3.3V_Rev1.1.SchDoc

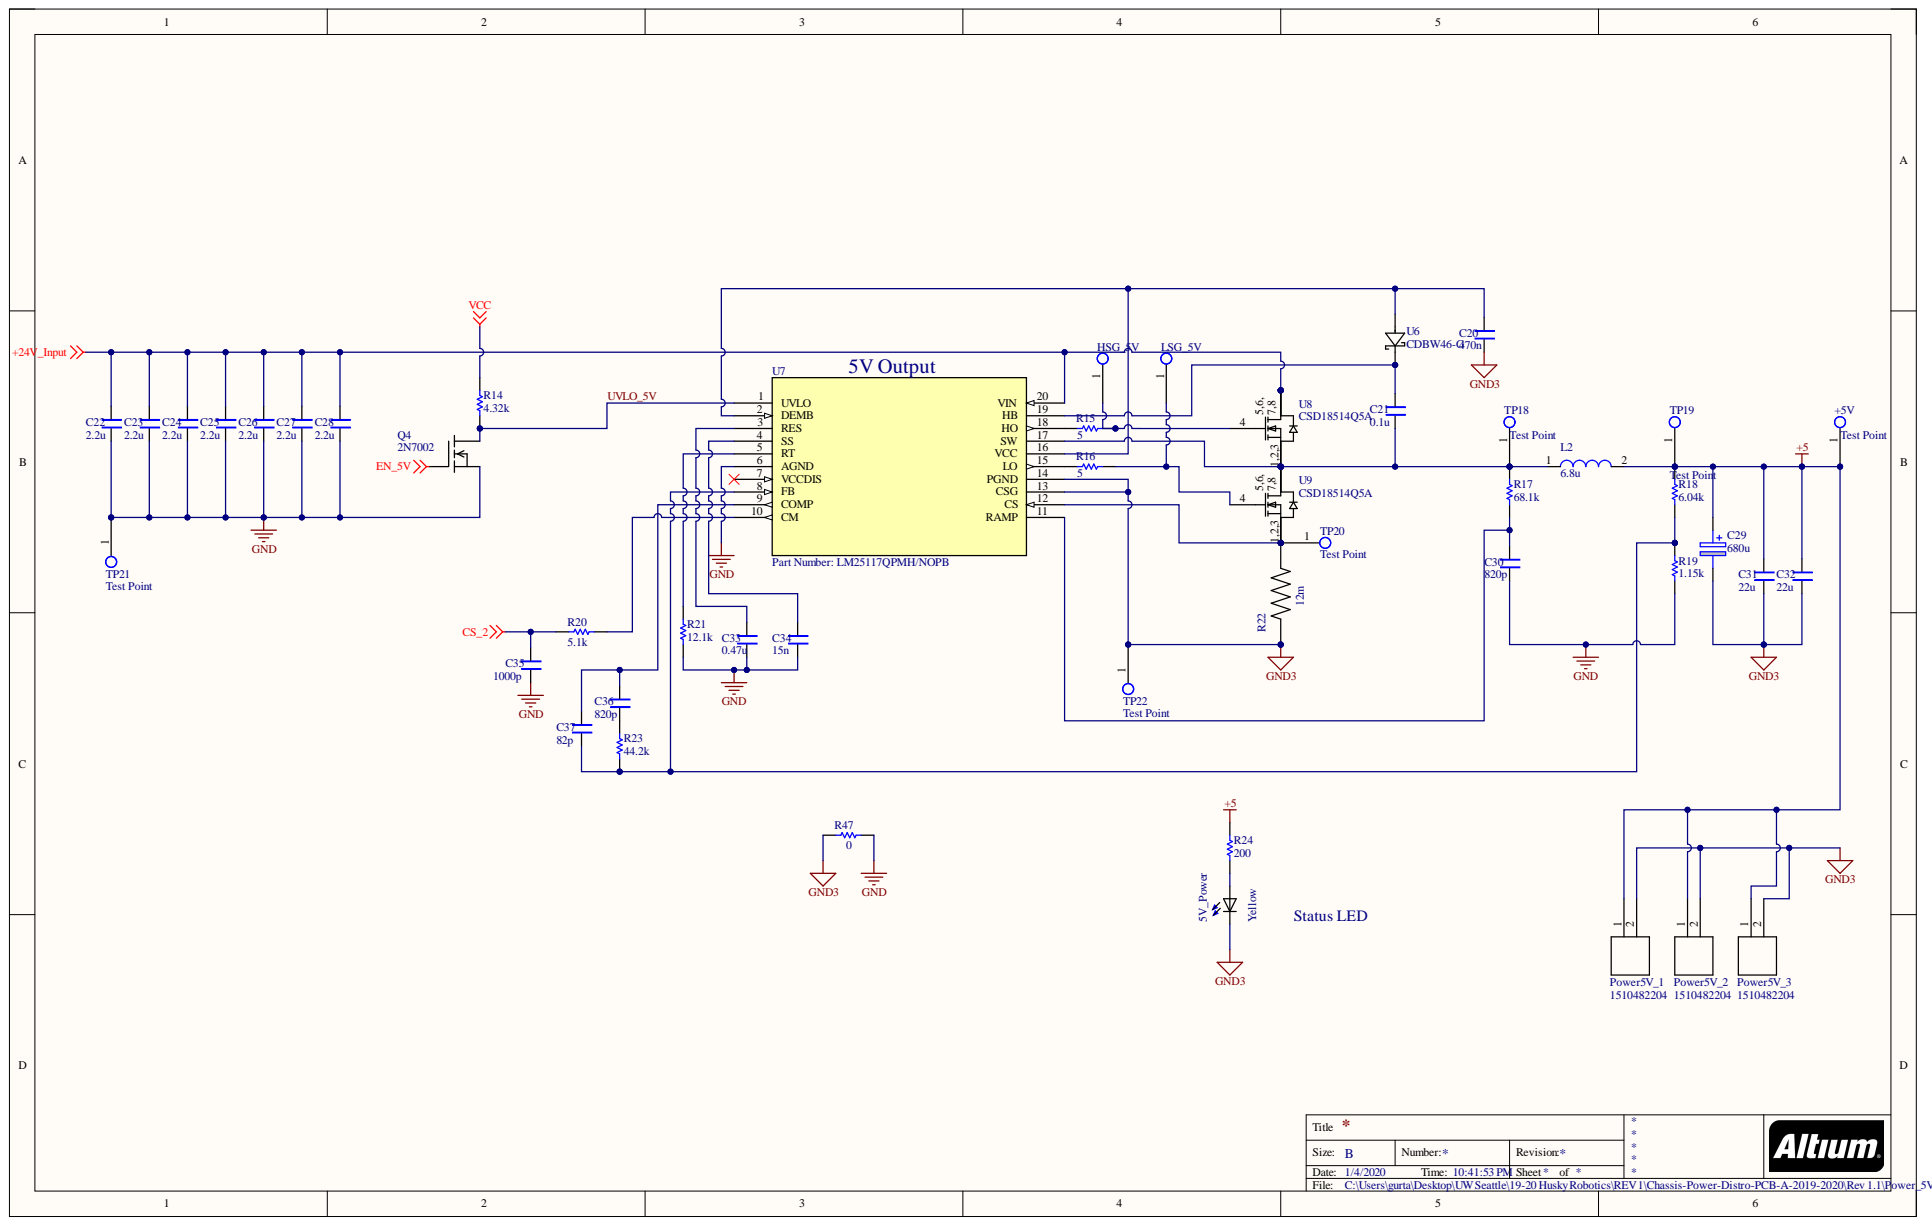
[picture p13: page 6]

4.32k | DEMB 2

RES 3 | R15 5
SS 4
RT 5
AGND 6

Title * | * * * * *

Size: B | Number: * | Revision: *
Date: 1/4/2020 Time: 10:41:53 PM | | Sheet * of *

C:\Users\gurta\Desktop\UWSeattle\19-20 HuskyRobotics\REV1\Chassis-Power-Distro-PCB-A-2019-2020\Rev 1.1\Power_5V_Rev1.1.SchDoc

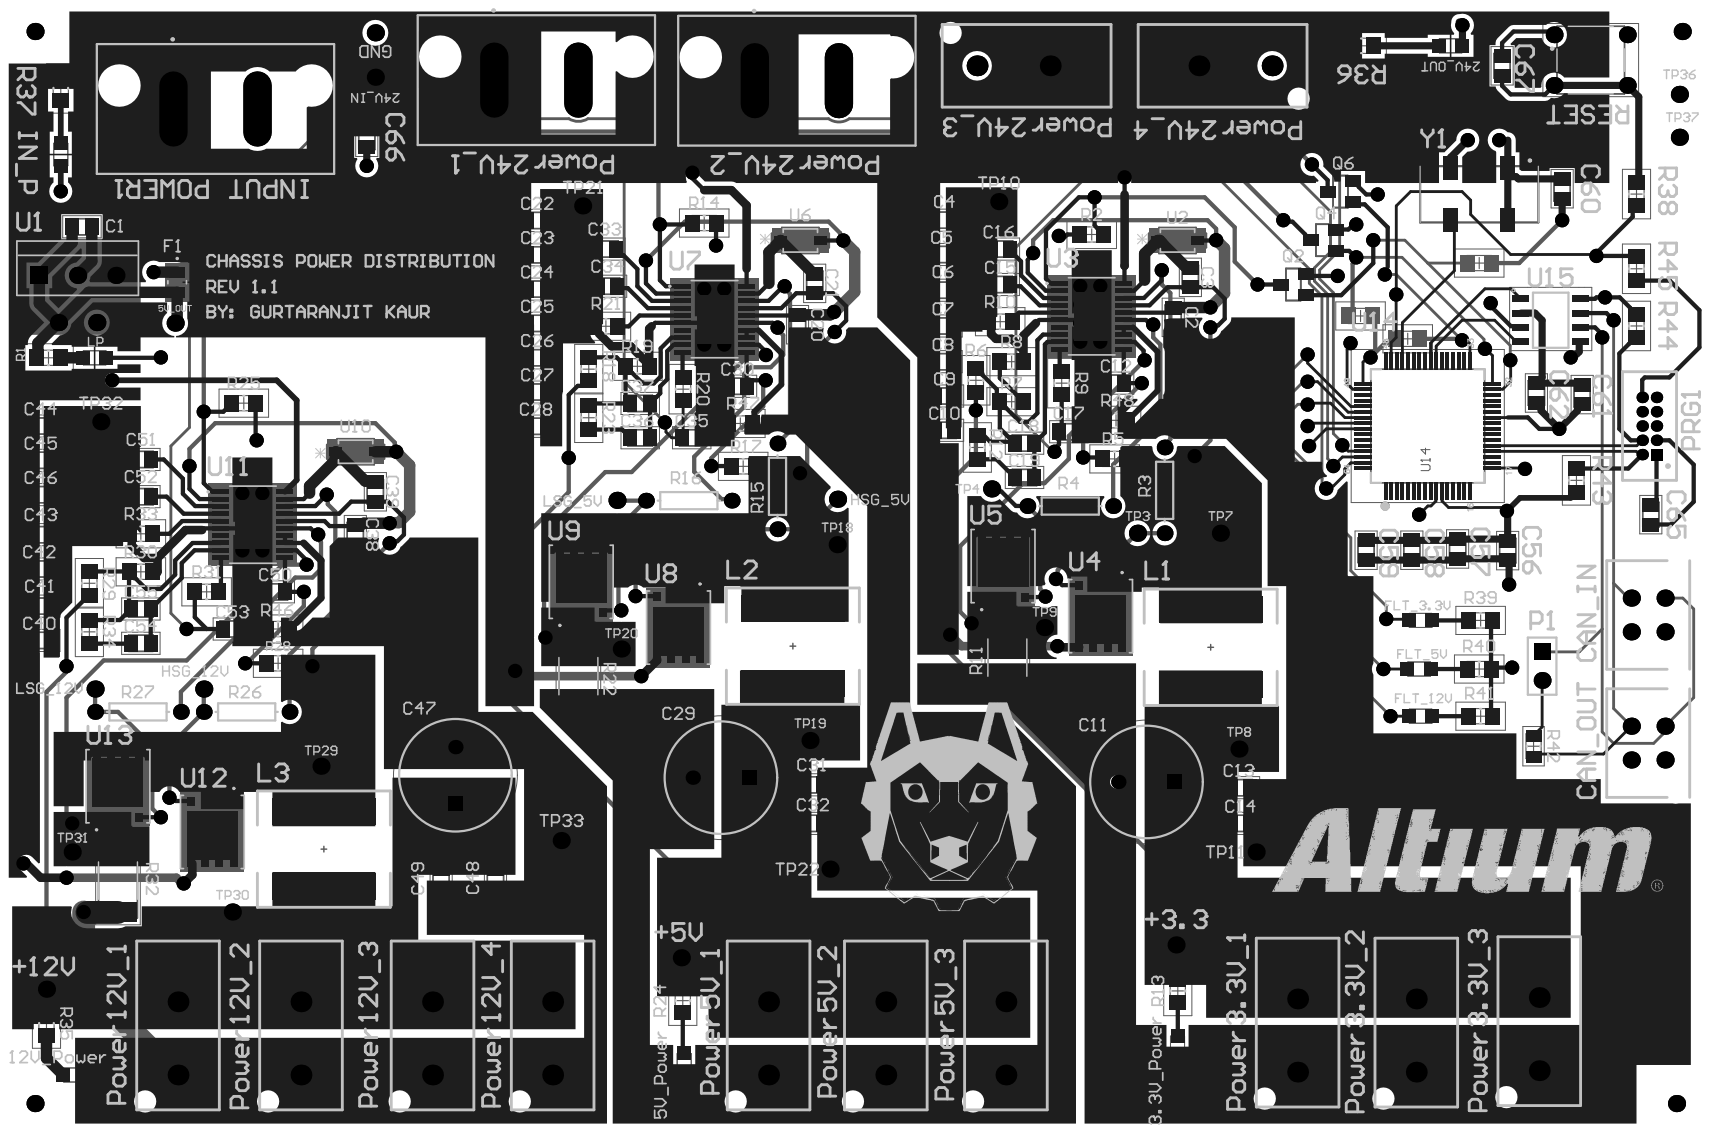
[picture p14: page 7]
