huskyroboticsteam/Chassis-Power-Distro-PCB-A-2019-2020/(list of files, drawings)

Other design files:
ChassisPowerDistroA_1.0_GK.PrjPcb
ChassisPowerDistroA_PSoC_1.0_GK.PcbDoc
Local_Power_5V.SchDoc
MCU_PSoC.SchDoc
NEW POWER DISTRO FOLDER/NewChassisPowerDistroA_PSoC_1.0/NewChassisPowerDistroA_PSoC_1.0.PrjPcb
Power_3.3V.SchDoc
Power_5V.SchDoc
Power_12V.SchDoc
Power_24V.SchDoc
Rev 1.1/ChassisPowerDistroA_1.1_GK.PrjPcb
Rev 1.1/ChassisPowerDistroA_PSoC_1.1_GK.PcbDoc
Rev 1.1/Local_Power_5V_Rev1.1.SchDoc
Rev 1.1/MCU_PSoC_Rev1.1.SchDoc
Rev 1.1/Power_3.3V_Rev1.1.SchDoc
Rev 1.1/Power_5V_Rev1.1.SchDoc
Rev 1.1/Power_12V_Rev1.1.SchDoc
Rev 1.1/Power_24V_Rev1.1.SchDoc
