huskyroboticsteam/Chassis-Power-Distro-PCB-A-2019-2020/(commit log)

2019-11-09 new power distro
    [Chassis_Power_Distro_A_Rev1.PrjPCB]
2019-11-20 Finished Schematic except 24V output converter connections.
    [Chassis_Power_Distro_A_Rev1.PrjPCB]
2019-11-21 Updated Hierarchical Schematic Design
    [Chassis_Power_Distro_A_Rev1.PrjPCB]
2019-11-24 Deleted INA226 Current Sensors. Complete Schematic
    [Chassis_Power_Distro_A_Rev1.PrjPCB]
2019-12-28 New Power Distro with complete schematic.
    [NewChassisPowerDistroA_PSoC_1.0.PrjPcb]
2019-12-28 Updated Schematic and PCB
    [ChassisPowerDistroA_PSoC_1.0_GK.PcbDoc, Local_Power_5V.SchDoc, MCU_PSoC.SchDoc, Power_12V.SchDoc, Power_24V.SchDoc, Power_3.3V.SchDoc, Power_5V.SchDoc]
2019-12-29 Completed PCB and Schematic before DRC
    [ChassisPowerDistroA_PSoC_1.0_GK.PcbDoc, Chassis_Power_Distro_A_Rev1.PrjPCB, Local_Power_5V.SchDoc, MCU_PSoC.SchDoc, Power_12V.SchDoc, Power_24V.SchDoc, Power_3.3V.SchDoc, Power_5V.SchDoc]
2019-12-29 Complete Schematic and PCB with Complete DRC
    [ChassisPowerDistroA_PSoC_1.0_GK.PcbDoc, Local_Power_5V.SchDoc, Power_24V.SchDoc]
2019-12-30 Added Logos to PCB
    [ChassisPowerDistroA_1.0_GK.PrjPcb, ChassisPowerDistroA_PSoC_1.0_GK.PcbDoc, Power_3.3V.SchDoc]
2020-01-03 2/3 Converters finished and routed.
    [ChassisPowerDistroA_1.1_GK.PrjPcb, ChassisPowerDistroA_PSoC_1.1_GK.PcbDoc, Local_Power_5V_Rev1.1.SchDoc, MCU_PSoC_Rev1.1.SchDoc, Power_12V_Rev1.1.SchDoc, Power_24V_Rev1.1.SchDoc, Power_3.3V_Rev1.1.SchDoc, Power_5V_Rev1.1.SchDoc]
2020-01-05 Finished PCB and Schematic
    [ChassisPowerDistroA_1.1_GK.PrjPcb, ChassisPowerDistroA_PSoC_1.1_GK.PcbDoc, Power_24V_Rev1.1.SchDoc]
2020-01-05 Added Pull-Down Resistors to UVLO
    [ChassisPowerDistroA_1.1_GK.PrjPcb, ChassisPowerDistroA_PSoC_1.1_GK.PcbDoc, MCU_PSoC_Rev1.1.SchDoc]
2020-01-05 Uploaded Gerber Files Zip File
2020-01-05 Uploaded PDF of all schematics and PCB
    [ChassisPowerDistroA_1.1_GK.PrjPcb, ChassisPowerDistroA_PSoC_1.1_GK.PcbDoc]
2020-01-06 Uploaded Drill File
2020-01-09 Updated PCB
    [ChassisPowerDistroA_1.1_GK.PrjPcb, Local_Power_5V_Rev1.1.SchDoc, MCU_PSoC_Rev1.1.SchDoc]
2020-01-09 Updated Gerber Files and PCB
2020-01-11 Uploaded Rev 1.1 BOM
    [PowerDistro BOM_2019-2020.xlsx]
2020-01-16 Updated BOM
    [PowerDistro BOM_2019-2020.xlsx]
2020-02-01 Fixed Connectors and uploaded new Gerber Files
    [ChassisPowerDistroA_1.1_GK.PrjPcb, Local_Power_5V_Rev1.1.SchDoc, MCU_PSoC_Rev1.1.SchDoc, PowerDistro BOM_2019-2020.xlsx, Power_12V_Rev1.1.SchDoc, Power_24V_Rev1.1.SchDoc, Power_3.3V_Rev1.1.SchDoc, Power_5V_Rev1.1.SchDoc]
2020-02-02 Edited Test points and Updated Gerber Files
    [ChassisPowerDistroA_1.1_GK.PrjPcb, MCU_PSoC_Rev1.1.SchDoc]
